MarcEdwin/Design2/README.md

# Design2
This repo hosts work by Smart Vibes for the Design 2 course at Florida Poly.

Feather tutorial: https://learn.adafruit.com/adafruit-feather-m0-wifi-atwinc1500/
