MarcEdwin/Design2/reports/02/02.tex

\documentclass[12pt]{article}

\usepackage{rotating}		% Use sidewaystable command
\usepackage{pdflscape}		% Produce landscape pages in a (mainly) portrait document
\usepackage{float}			% Added this package to place things right where I want them!
\usepackage{mathtools}		% Added this package in order to use shortintertext command
\usepackage{amsmath}
\usepackage{amssymb}
\usepackage{geometry}
\usepackage{graphicx}
\usepackage{tikz}
\usepackage{epstopdf}
\usepackage{caption}
\usepackage{subcaption}
\usepackage{hyperref}

\geometry{letterpaper,tmargin=1in,bmargin=1in,lmargin=1in,rmargin=1in}
\hypersetup{
colorlinks,linkcolor=black,citecolor=violet,urlcolor=blue
}

\allowdisplaybreaks			% Allows equations to be split across multiple pages

\begin{document}

\title{Design 2 Bi-Weekly Report 2}
\author{Smart Vibes}
%\date{January 23, 2017}
\maketitle

\newpage
\tableofcontents

\newpage
\section{These Past Two Weeks}
During the last two weeks, we finalized our bill of materials by updating the price of certain parts and adding in a few more parts necessary for our sensor. Some of these parts include an antenna to extend the range of wireless communication and a capacitor to help the lithium-ion battery charge off the solar panel. In addition, we also revised the functional diagram and started programming the Adafruit Feather microcontroller.

\begin{figure}[H]
    \centering
    
    \caption{Functional diagram for the vibration sensor designed by Smart Vibes. This latest revision highlights the main subsystems of the sensor and depicts the connection between all the components.}
    \label{fig:gantt_chart}
\end{figure}

\begin{table}[H]
	\centering
	\resizebox{\columnwidth}{!}{%
	\begin{tabular}{l|l|c|l|l|r|c|c}
    	Vendor ID & Part Number & Quantity & Price/Unit & Part Description & Cost & Vendor & Datasheet\\ \hline
    	1120 & LSM303 & 2 & \$14.95 & Accelerometer & \$29.90 & \href{https://www.adafruit.com/products/1120}{Adafruit} & \href{https://cdn-shop.adafruit.com/datasheets/LSM303DLHC.PDF}{PDF} \\
    	2693 & N.A. & 2 & \$19.95 & 16GB MicroSD Card & \$39.90 & \href{https://www.adafruit.com/products/2693}{Adafruit} & \href{https://www.adafruit.com/products/2693}{Website} \\
    	2922 & N.A. & 2 & \$8.95 & SD Card Breakout & \$17.90 & \href{https://www.adafruit.com/products/2922}{Adafruit} & \href{http://www.nxp.com/documents/data_sheet/PCF8523.pdf}{PDF} \\
    	& & & & with Coin Cell Battery & & & \\
    	%380 & CR1220 & 2 & \$0.95 & Coin Cell Battery & \$1.90 & \href{https://www.adafruit.com/products/380}{Adafruit} & \href{https://www.adafruit.com/products/380}{Website} \\
    	3061 & N.A. & 1 & \$34.95 & Adafruit Feather & \$34.95 & \href{https://www.adafruit.com/products/3061}{Adafruit} & \href{https://learn.adafruit.com/system/assets/assets/000/030/130/original/atmel-42181-sam-d21_datasheet.pdf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}{PDF} \\
    	353 & N.A. & 2 & \$29.50 & 6600 mAh 3.7V Lithium- & \$59.00 & \href{https://www.adafruit.com/product/353}{Adafruit} & \href{https://cdn-shop.adafruit.com/product-files/353/C450_-_ICR18650_6600mAh_3.7V_20140729.pdf}{PDF} \\
    	& & & & Ion Battery & & \\
    	2747 & N.A. & 1 & \$88.95 & Solar Panel & \$88.95 & \href{https://www.adafruit.com/products/2747}{Adafruit} & \href{https://www.voltaicsystems.com/9-watt-panel}{Website} \\
    	579-MCP73871-2CCI/ML & MCP73871-2CCI/ML & 1 & \$1.94 & Battery Charger & \$1.94 & \href{http://www.mouser.com/ProductDetail/Microchip-Technology/MCP73871-2CCI-ML/?qs=qXsUupcbpXyQfJ2clznZxw\%3D\%3D}{Mouser} & \href{http://www.mouser.com/ds/2/268/22090a-52174.pdf}{PDF} \\
		N.A. & 474-SEN-11744 & 1 & \$61.25 & Geophone & \$61.25 & \href{http://www.mouser.com/ProductDetail/SparkFun-Electronics/SEN-11744/?qs=\%2fha2pyFaduhLW6YoPw5UUIdTRP1X\%252btPruyfOHvl8\%2fY0\%3d}{Mouser} & \href{http://cdn.sparkfun.com/datasheets/Sensors/Accelerometers/SM-24\%20Brochure.pdf}{PDF} \\
    	 39RL33 & N.A. & 1 & \$34.75 & White Nylon Filament & \$34.75 & \href{https://www.grainger.com/product/FILABOT-White-Filament-39RL33}{Grainger} & \href{https://www.grainger.com/product/FILABOT-White-Filament-39RL33}{Website} \\
    	 & & & & for 3-D Printer & & \\
    	 2788 & N.A. & 1 & \$0.95 & DC Jack Adapter Cable & \$0.95 & \href{https://www.adafruit.com/products/2788}{Adafruit} & \href{https://www.adafruit.com/products/2788}{Website} \\
    	 & & & & for Battery Charger & & & \\
    	 581-TAP475K016SCS & TAP475K016SCS & 1 & \$0.67 & Tantalum Capacitor & \$0.67 & \href{http://www.mouser.com/ProductDetail/AVX/TAP475K016SCS/?qs=sGAEpiMZZMtZ1n0r9vR22d\%252b8XmbM9QM8L4TTXY3LGQ8\%3d}{Mouser} & \href{http://www.mouser.com/ds/2/40/tap-776819.pdf}{PDF} \\
    	 & & & & for Battery Charger & & & \\
    	 261 & N.A. & 1 & \$0.75 & JST 2-pin Cable & \$0.75 & \href{https://www.adafruit.com/product/261}{Adafruit} & \href{https://www.adafruit.com/product/261}{Website} \\
    	 & & & & for Battery Charger & & & \\
    	 	PMT-37N28AL01-04-ND & PMT-37N28AL01-04 & 1 & \$8.57 & Speaker & \$8.57 & \href{http://www.digikey.com/product-detail/en/peerless-by-tymphany/PMT-37N28AL01-04/PMT-37N28AL01-04-ND/6211115}{Digi-Key} & \href{http://www.tymphany.com/wp-content/themes/pathfinders/cache/pdfs/PMT-37N28AL01-04.pdf}{PDF} \\
        2308 & N.A. & 1 & \$2.50 & Antenna with uFL & \$2.50 & \href{https://www.adafruit.com/products/2308}{Adafruit} & \href{https://www.adafruit.com/products/2308}{Website} \\
    	 & & & & Connector & & & \\ \hline
    	Total Cost & & & & & \$381.98 &
	\end{tabular}%
	}
    \caption{Bill of materials for the vibration sensor designed by Smart Vibes. This latest revision ensures compatibility between all the components.}
    \label{tab:bom}
\end{table}

\section{What's Next?}
\begin{itemize}
\item Keep programming and familiarizing ourselves with the microcontroller.
\item Order the parts in our BOM.
\item Work on the design of our housing using prototyping foam.
\end{itemize}

\section{Responsibilities}
The responsibilities of each group member has not changed since the last report. The distribution of work in Smart Vibes is as follows:\\

\noindent \textbf{Joshua Watkins} - \textit{Mechanical/Design} - Responsibilities include designing an enclosure for the sensors that will maximize the sensor's capabilities while minimizing cost.\\

\noindent \textbf{Marc-Edwin Rigaud} - \textit{Programming} - Responsibility is to program the microcontroller, and arrange website and cloud-based services.\\

\noindent \textbf{Jordan Faison} - \textit{Electrical/Design/Programming} - Responsibilities will be assisting in design from an electrical aspect, as well as software development.\\

\noindent \textbf{Ezequiel Juarez G.} - \textit{Electrical/Programming} - Responsibilities include assembling the vibration sensor system using all of the electronics at our disposal and aiding with the programming/debugging of software.

\end{document}
