MarcEdwin/Design2/docs/sensor_improvements.md

## Battery improvements

- temperature sensor across THERM
- 1kohm resistor across PROG
- run mini-usb port to the outside for charging
