MarcEdwin/Design2/presentations/04_Design_2_Progress_Presentation_2.pdf

# SmartVibes

# Progress Report Deux

What we set out to create...

Smart Structures asked us to design a robust and portable vibration monitoring solution.

The solution would be used to monitor ground vibrations at a construction site.

We decided it needed to meet the following requirements:

- Use an accelerometer and geophone
- Monitor minimum frequency of 8hz
- Store data locally
- Provide immediate emergency triggers
- Provide real time monitoring
- Have WiFi connectivity
- Cloud database, remote access
- Four-week power time
- Weather resistant

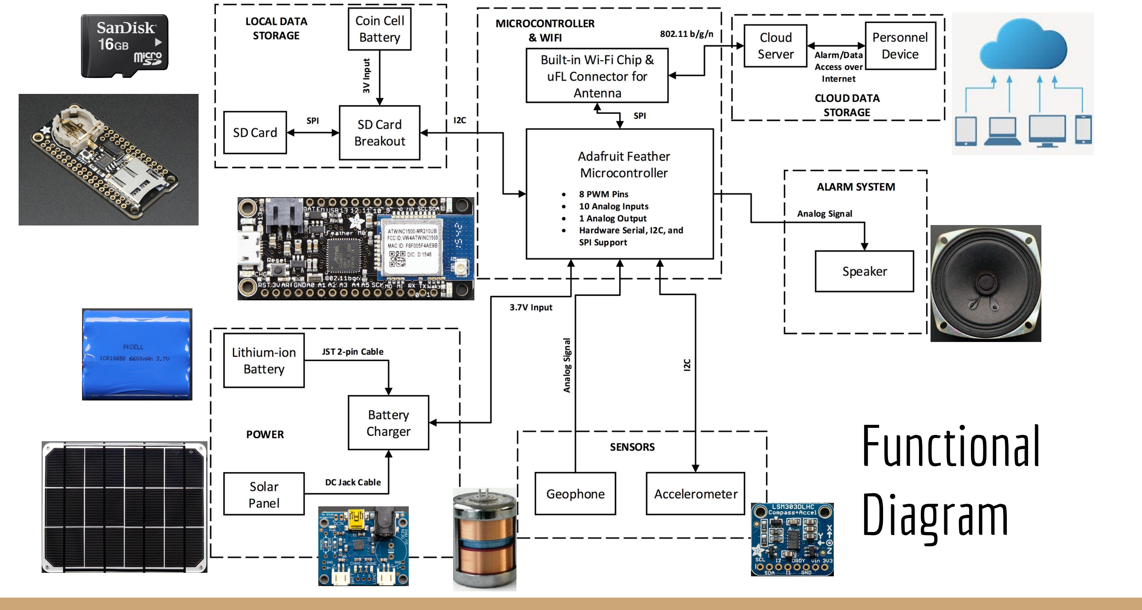
[picture p14: page 3]

# Functional Diagram

# State of Enclosure

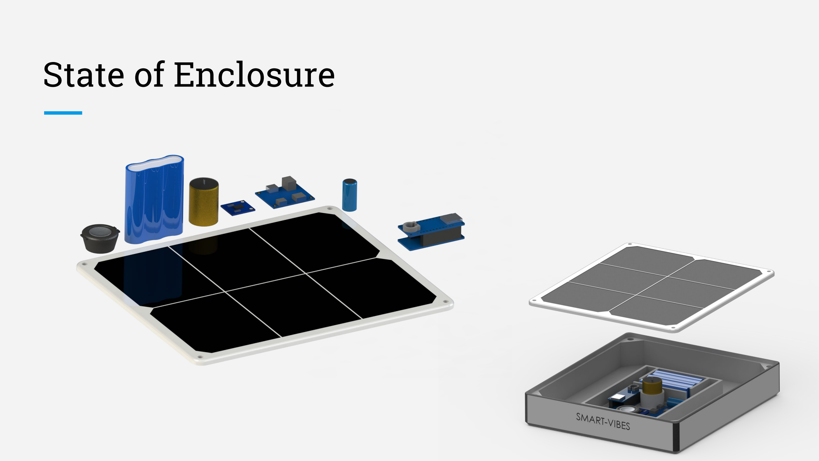
[picture p15: page 4]

# State of Enclosure

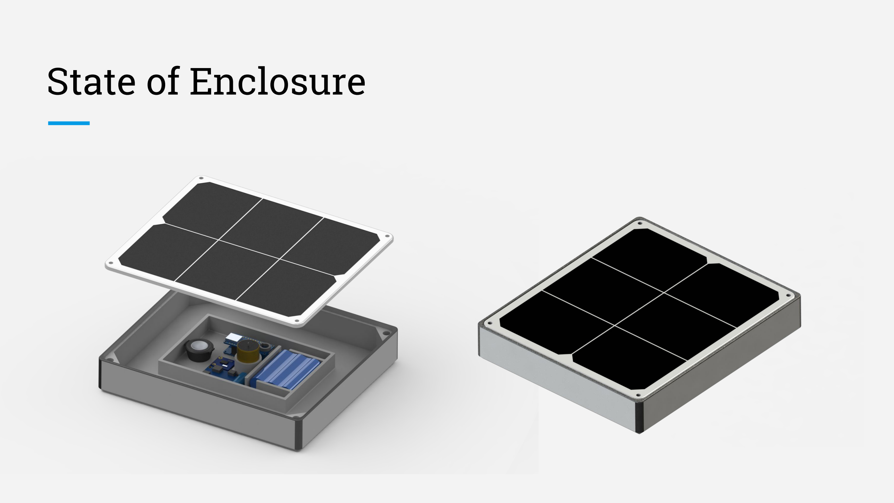
[picture p16: page 5]

# State of Sensors

Progress

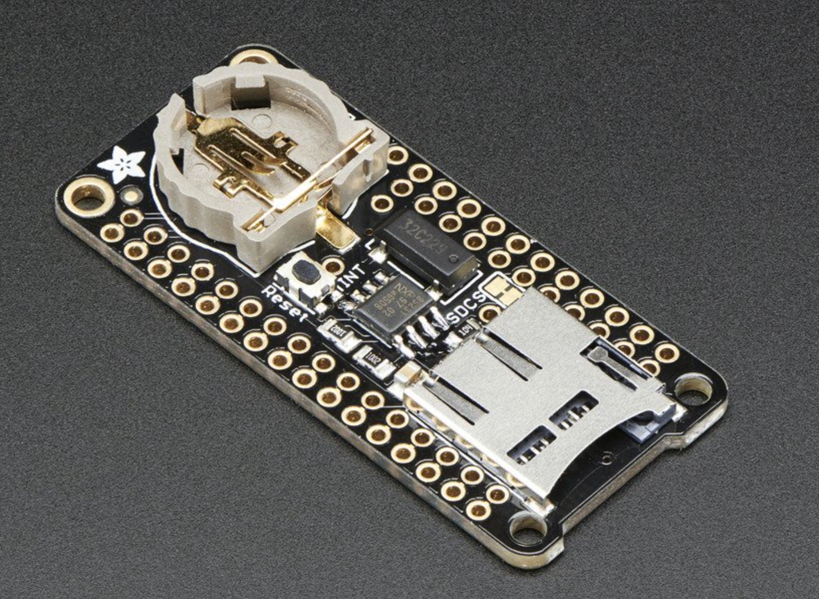
[picture p17: figure]

- Accelerometer data is being gathered over I2C.
- RTC clock has been set. Data can now be timestamped correctly.
- Analog data from geophone is being collected.

Problems

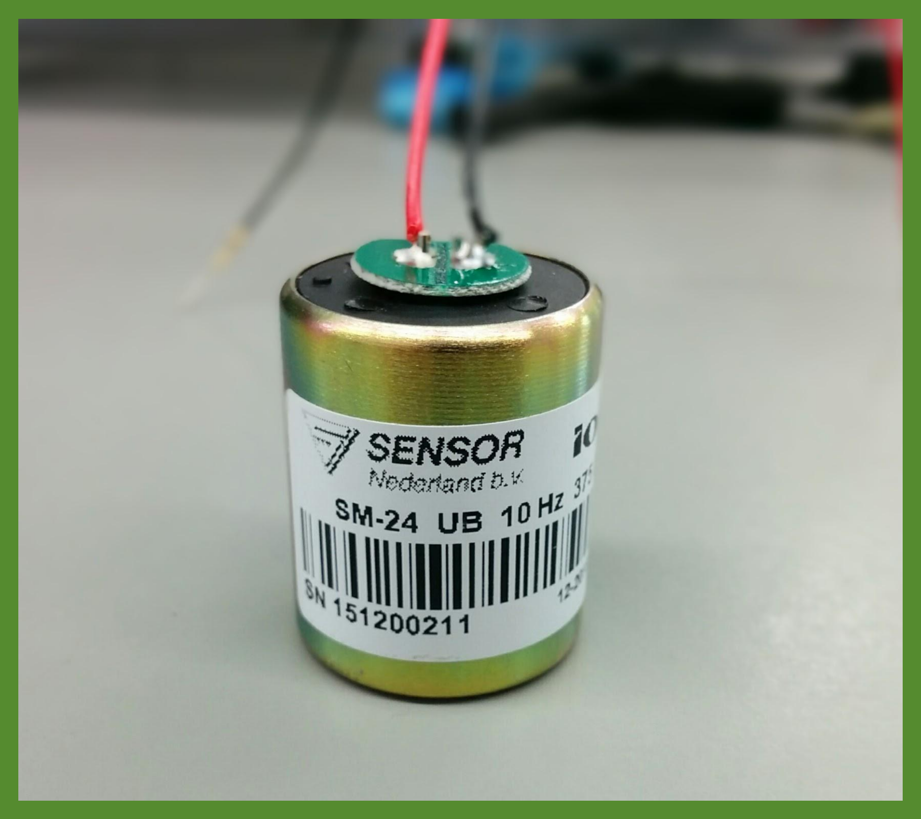
[picture p18: figure]

- Interrupts are have been difficult to set up.
- Lack of accessible FFT library for the Feather makes it difficult to calculate the frequency of vibrations.

# State of Sensors

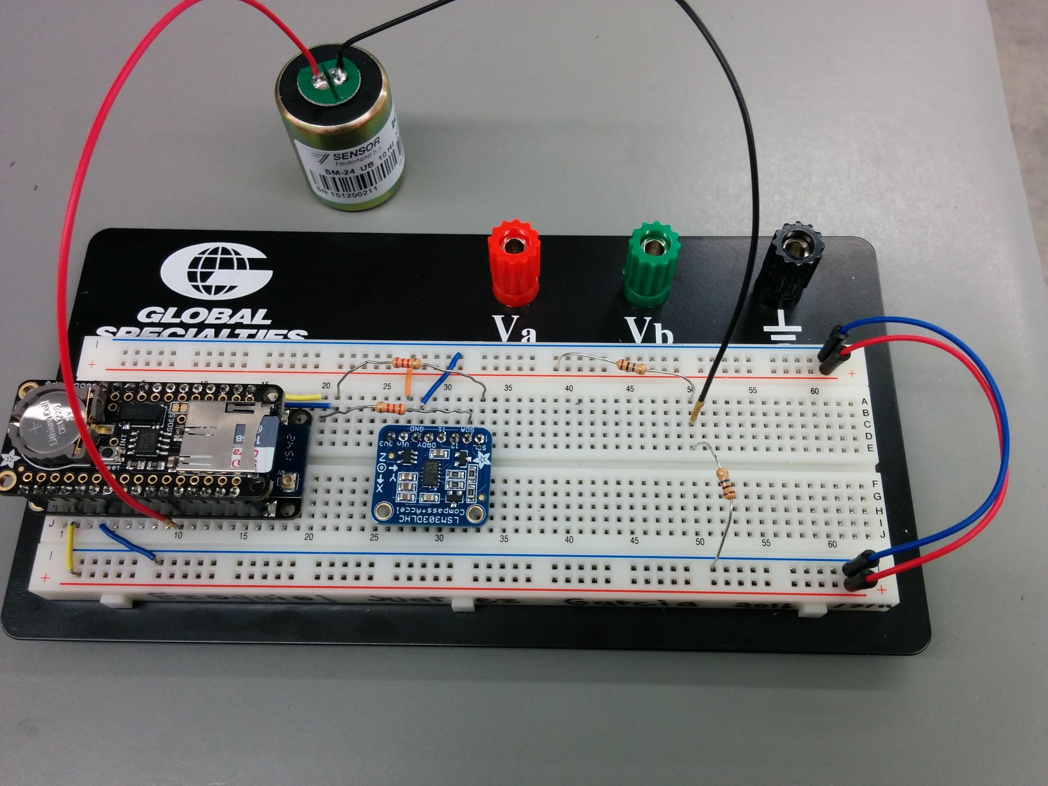
[picture p19: figure]

# State of Data-linking

- Now using Microsoft Azure IoT Hub platform
- This allows us to send messages to and from the Feather via wireless module
- It uses gulp.js, a toolkit that allows us to automate tasks
- Create Functions that make these messages meaningful
- Data Storage/ Management
- Data interrupts and signal issues
- Alarm system

# Next Steps

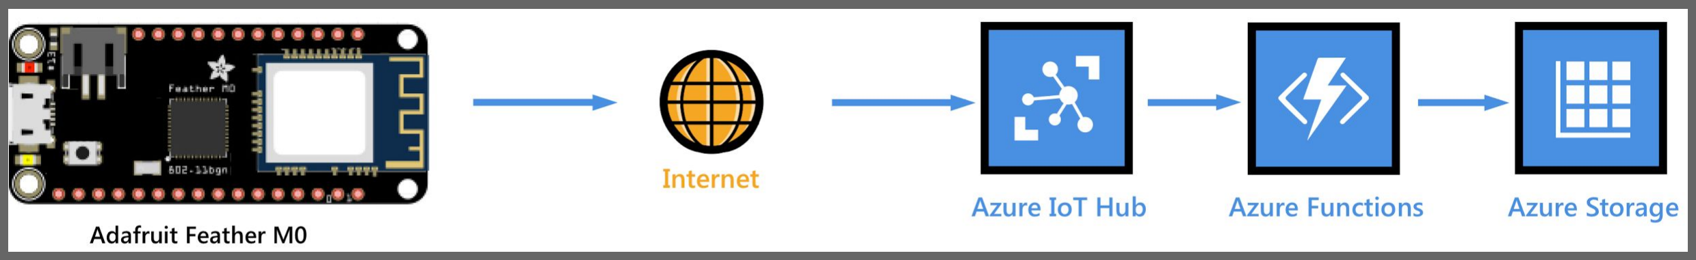
[picture p20: figure]

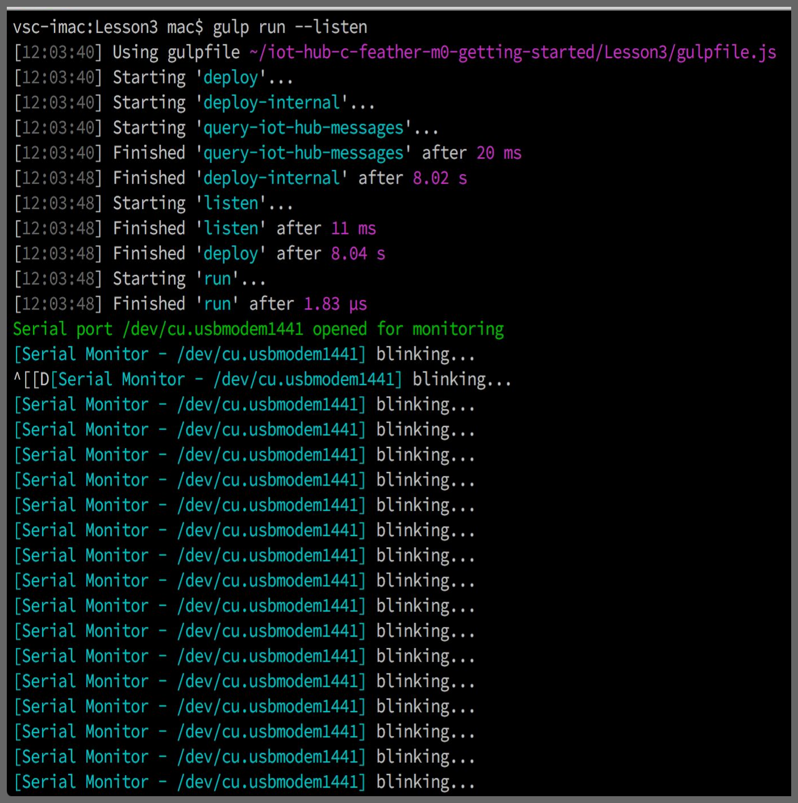
[picture p21: figure]

# State of Data-linking

Using gulp file to send messages

reporting to the serial monitor and

sending them to the database

# State of Database

- We will be using Microsoft Azure IoT’s built in storage known as Microsoft

Azure Storage.

- The specific database we will use is Table Storage.
- Table storage is a NoSQL key-attribute data store, which allows for rapid

development and fast access to large quantities of data.

# State of Database cont'd

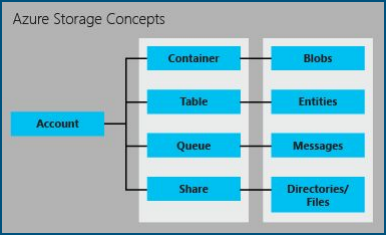
[picture p22: figure]

# What's Next?

- Collect both geophone and accelerometer data and store on SD card.
- Program alarm.
- Look into the FFT problem.
- Collectively look into the battery and solar power aspect.
- 3-D print the housing.

# Division of Work

Josh - Enclosure

Zeq- Sensor array

Jordan- Data linking

Marc- Database
