MarcEdwin/Design2/presentations/02_Design_2_Bi-Weekly_Presentation_Never_Presented.pdf

# Design 2 Bi-Weekly Presentation 2

## Smart Vibes January 23, 2016

These Past Two Weeks….

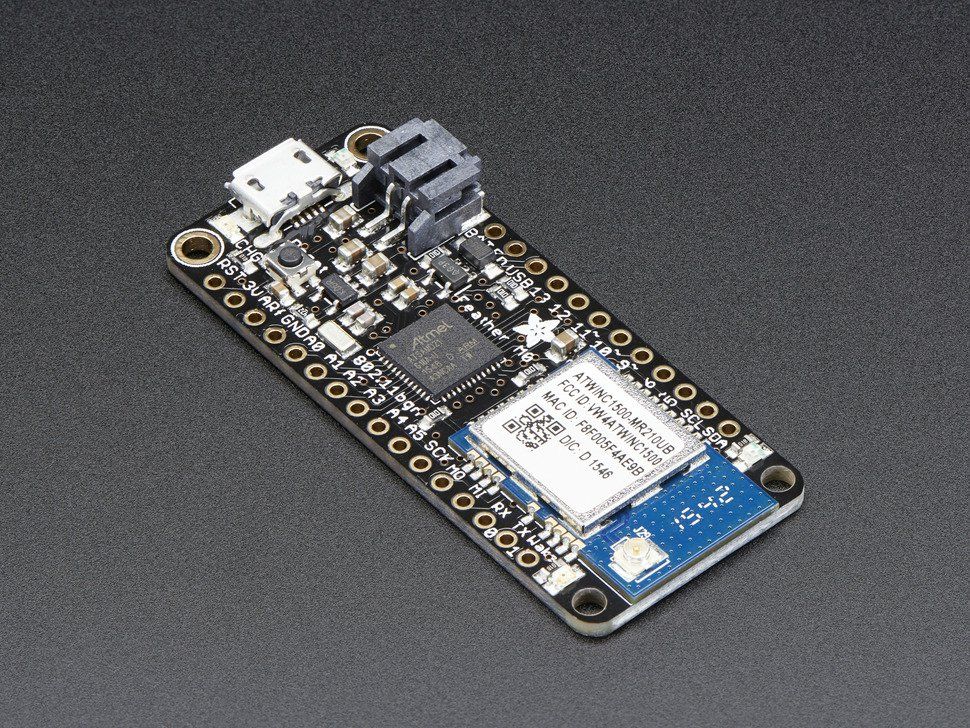
[picture p23: figure]

We started programming

the Adafruit Feather

microcontroller.

# Modified the BOM

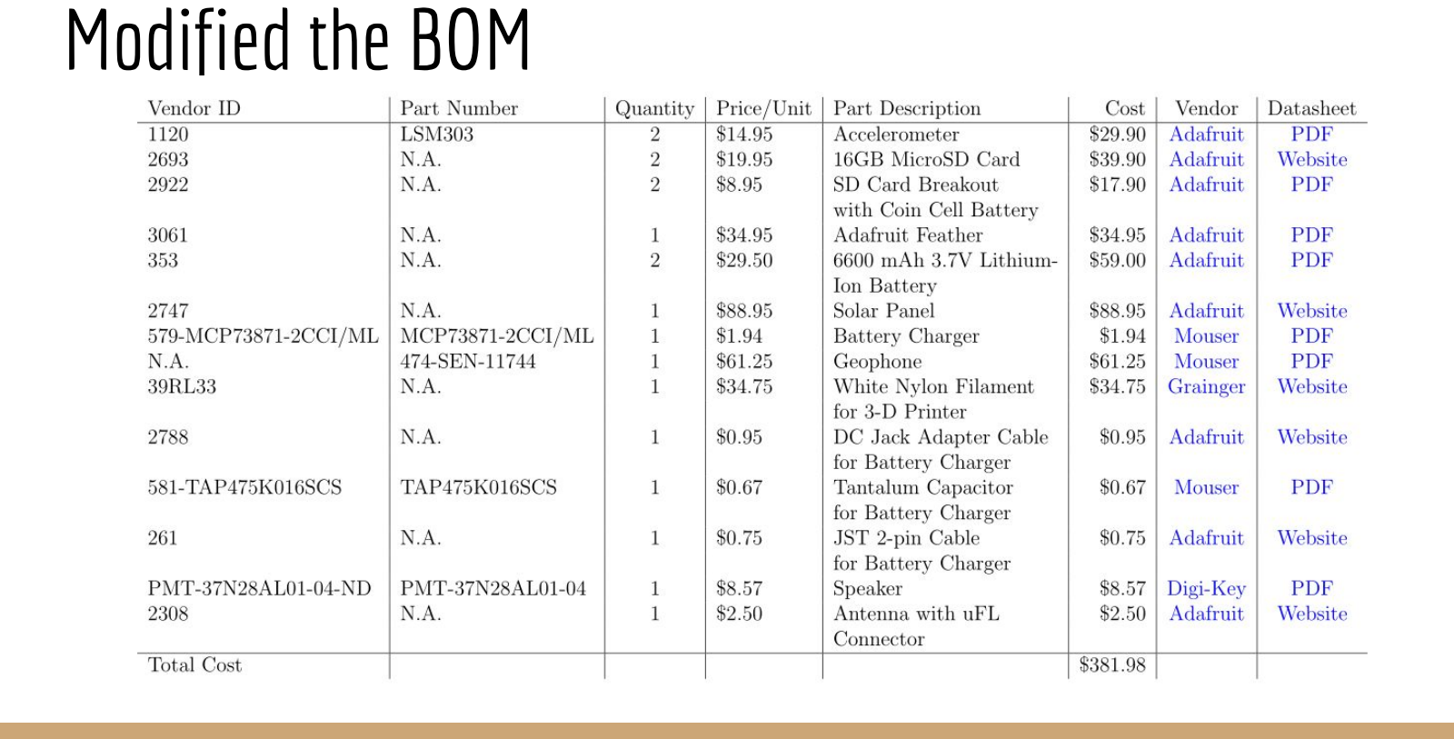
[picture p24: page 3]

# Modified the Functional Diagram

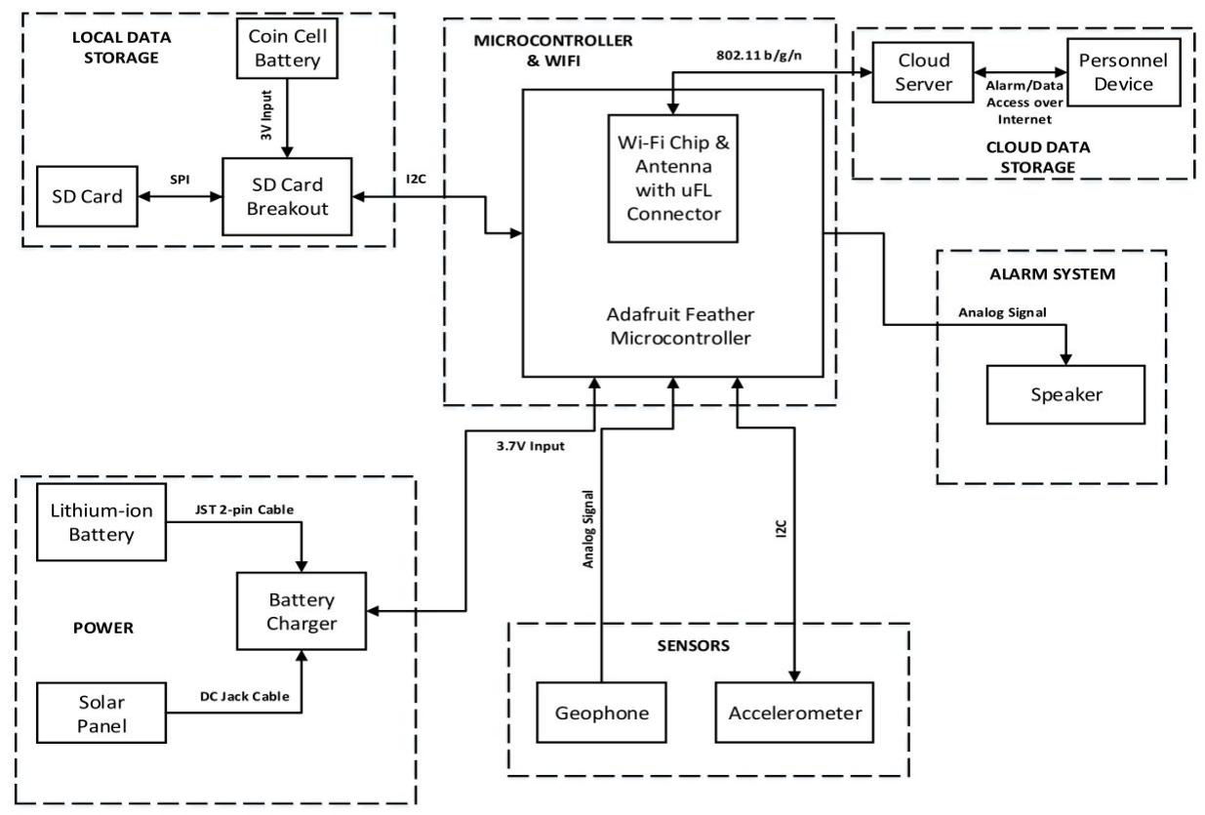
[picture p25: figure]

# What’s Next

- Keep programming and familiarizing ourselves with the microcontroller.
- Order the parts in our BOM.
- Work on the design of our housing using prototyping foam.

# Work Distribution

Joshua Watkins - Mechanical/Design

Marc-Edwin Rigaud - Programming

Jordan Faison - Electrical/Design/Programming

Ezequiel Juarez - Electrical/Programming

# Questions? Comments? Compliments?
