MarcEdwin/Design2/reports/02/02.pdf

# Design 2 Bi-Weekly Report 2

### Smart Vibes

### February 6, 2017

## Contents

1 These Past Two Weeks | 3
2 What’s Next? | 4
3 Responsibilities | 4

## 1 These Past Two Weeks

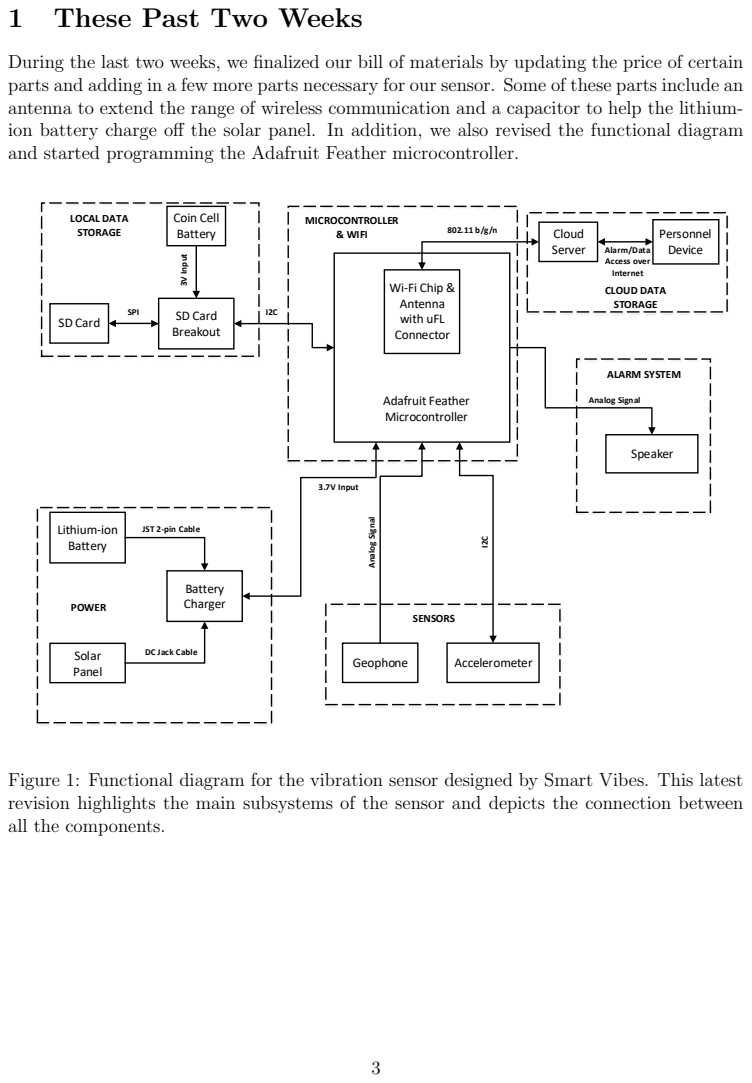
[picture p26: page 3]
Adafruit Feather Microcontroller; SD Card Breakout; Coin Cell Battery; SD Card; Cloud Server; Personnel Device; Geophone; Accelerometer; Lithium-ion Battery; Battery Charger; Solar Panel; Speaker; Analog Signal; Alarm/Data Access over Internet; SPI; 3.7V Input; 3V Input; ALARM SYSTEM; MICROCONTROLLER & WIFI; CLOUD DATA STORAGE; LOCAL DATA STORAGE; SENSORS; POWER

During the last two weeks, we finalized our bill of materials by updating the price of certain
parts and adding in a few more parts necessary for our sensor. Some of these parts include an
antenna to extend the range of wireless communication and a capacitor to help the lithium-
ion battery charge off the solar panel. In addition, we also revised the functional diagram
and started programming the Adafruit Feather microcontroller.

Wi-Fi Chip &
Antenna
with uFL
Connector

JST 2-pin Cable

DC Jack Cable

Figure 1: Functional diagram for the vibration sensor designed by Smart Vibes. This latest
revision highlights the main subsystems of the sensor and depicts the connection between
all the components.

Vendor ID | Part Number | Quantity | Price/Unit | Part Description | Cost | Vendor | Datasheet
1120 | LSM303 | 2 | $14.95 | Accelerometer | $29.90 | Adafruit (https://www.adafruit.com/products/1120) | PDF (https://cdn-shop.adafruit.com/datasheets/LSM303DLHC.PDF)
2693 | N.A. | 2 | $19.95 | 16GB MicroSD Card | $39.90 | Adafruit (https://www.adafruit.com/products/2693) | Website (https://www.adafruit.com/products/2693)
2922 | N.A. | 2 | $8.95 | SD Card Breakout | $17.90 | Adafruit (https://www.adafruit.com/products/2922) | PDF (http://www.nxp.com/documents/data_sheet/PCF8523.pdf)
| | | | with Coin Cell Battery
3061 | N.A. | 1 | $34.95 | Adafruit Feather | $34.95 | Adafruit (https://www.adafruit.com/products/3061) | PDF (https://learn.adafruit.com/system/assets/assets/000/030/130/original/atmel-42181-sam-d21_datasheet.pdf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)
353 | N.A. | 2 | $29.50 | 6600 mAh 3.7V Lithium- | $59.00 | Adafruit (https://www.adafruit.com/product/353) | PDF (https://cdn-shop.adafruit.com/product-files/353/C450_-_ICR18650_6600mAh_3.7V_20140729.pdf)
| | | | Ion Battery
2747 | N.A. | 1 | $88.95 | Solar Panel | $88.95 | Adafruit (https://www.adafruit.com/products/2747) | Website (https://www.voltaicsystems.com/9-watt-panel)
579-MCP73871-2CCI/ML | MCP73871-2CCI/ML | 1 | $1.94 | Battery Charger | $1.94 | Mouser (http://www.mouser.com/ProductDetail/Microchip-Technology/MCP73871-2CCI-ML/?qs=qXsUupcbpXyQfJ2clznZxw%3D%3D) | PDF (http://www.mouser.com/ds/2/268/22090a-52174.pdf)
N.A. | 474-SEN-11744 | 1 | $61.25 | Geophone | $61.25 | Mouser (http://www.mouser.com/ProductDetail/SparkFun-Electronics/SEN-11744/) | PDF (http://cdn.sparkfun.com/datasheets/Sensors/Accelerometers/SM-24%20Brochure.pdf)
39RL33 | N.A. | 1 | $34.75 | White Nylon Filament | $34.75 | Grainger (https://www.grainger.com/product/FILABOT-White-Filament-39RL33) | Website (https://www.grainger.com/product/FILABOT-White-Filament-39RL33)
| | | | for 3-D Printer
2788 | N.A. | 1 | $0.95 | DC Jack Adapter Cable | $0.95 | Adafruit (https://www.adafruit.com/products/2788) | Website (https://www.adafruit.com/products/2788)
| | | | for Battery Charger
581-TAP475K016SCS | TAP475K016SCS | 1 | $0.67 | Tantalum Capacitor | $0.67 | Mouser (http://www.mouser.com/ProductDetail/AVX/TAP475K016SCS/) | PDF (http://www.mouser.com/ds/2/40/tap-776819.pdf)
| | | | for Battery Charger
261 | N.A. | 1 | $0.75 | JST 2-pin Cable | $0.75 | Adafruit (https://www.adafruit.com/product/261) | Website (https://www.adafruit.com/product/261)
| | | | for Battery Charger
PMT-37N28AL01-04-ND | PMT-37N28AL01-04 | 1 | $8.57 | Speaker | $8.57 | Digi-Key (http://www.digikey.com/product-detail/en/peerless-by-tymphany/PMT-37N28AL01-04/PMT-37N28AL01-04-ND/6211115) | PDF (http://www.tymphany.com/wp-content/themes/pathfinders/cache/pdfs/PMT-37N28AL01-04.pdf)
2308 | N.A. | 1 | $2.50 | Antenna with uFL | $2.50 | Adafruit (https://www.adafruit.com/products/2308) | Website (https://www.adafruit.com/products/2308)
| | | | Connector
Total Cost | | | | | $381.98

Table 1: Bill of materials for the vibration sensor designed by Smart Vibes. This latest revision ensures compatibility between all the components.

## 2 What’s Next?

- Keep programming and familiarizing ourselves with the microcontroller.
- Order the parts in our BOM.
- Work on the design of our housing using prototyping foam.

## 3 Responsibilities

The responsibilities of each group member has not changed since the last report. The distribution of work in Smart Vibes is as follows:

Joshua Watkins - Mechanical/Design - Responsibilities include designing an enclosure for the sensors that will maximize the sensor’s capabilities while minimizing cost.

Marc-Edwin Rigaud - Programming - Responsibility is to program the microcontroller, and arrange website and cloud-based services.

Jordan Faison - Electrical/Design/Programming - Responsibilities will be assisting in design from an electrical aspect, as well as software development.

Ezequiel Juarez G. - Electrical/Programming - Responsibilities include assembling the vibration sensor system using all of the electronics at our disposal and aiding with the programming/debugging of software.
