MarcEdwin/Design2/reports/02/src/functional_diagram.pdf

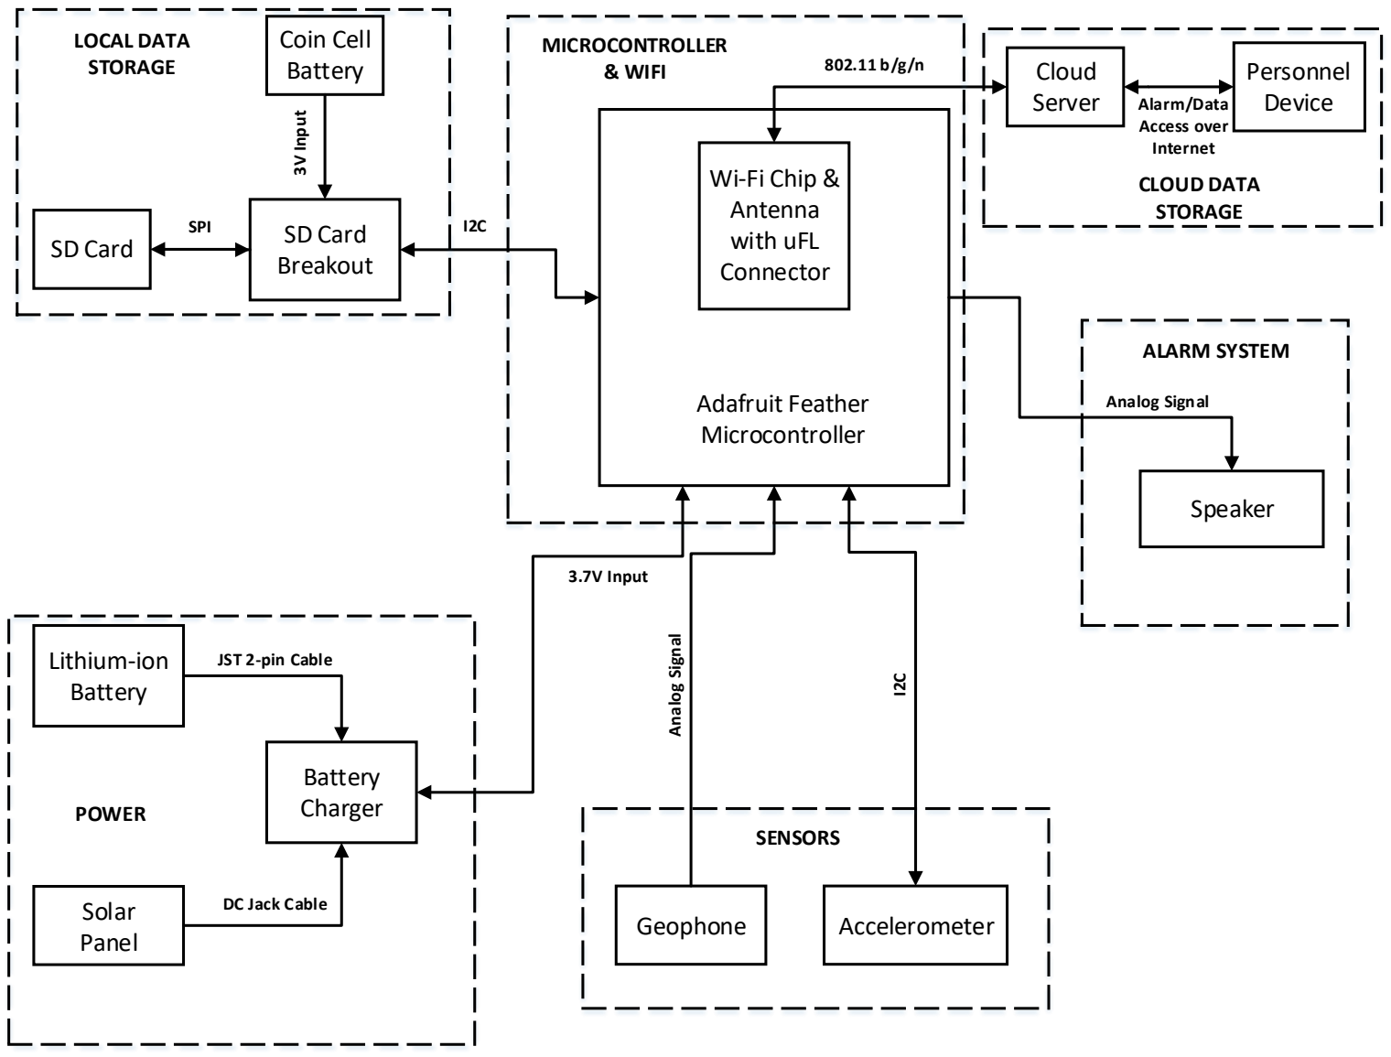
[picture p27: page 1]

Adafruit Feather
Microcontroller

SD Card
Breakout

Coin Cell
Battery

SD Card

Cloud
Server

Personnel
Device
Geophone | Accelerometer

Lithium-ion
Battery

Battery
Charger

Solar
Panel

Speaker

Wi-Fi Chip &
Antenna
with uFL
Connector

JST 2-pin Cable

DC Jack Cable

Analog Signal

I2C

Analog Signal

802.11 b/g/n

Alarm/Data
Access over
Internet
SPI | I2C

3.7V Input

3V Input

ALARM SYSTEM

MICROCONTROLLER
& WIFI

CLOUD DATA
STORAGE

LOCAL DATA
STORAGE

SENSORS

POWER
