MarcEdwin/Design2/functional_diagram/functional_diagram.pdf

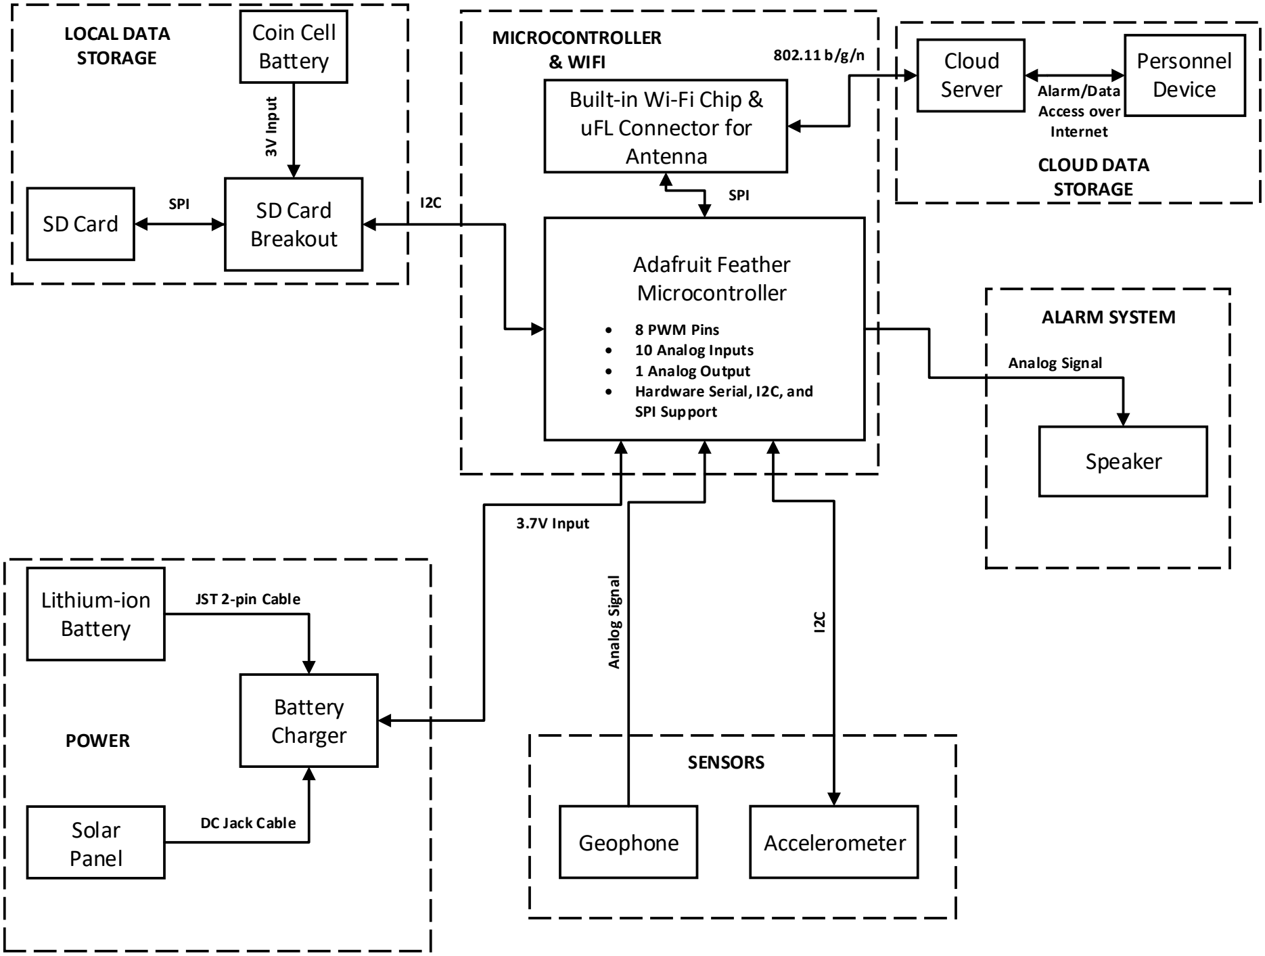
[picture p28: figure]
Adafruit Feather Microcontroller; SD Card Breakout; Coin Cell Battery; SD Card; Cloud Server; Personnel Device; Geophone; Accelerometer; Lithium-ion Battery; Battery Charger; Solar Panel; Speaker; Built-in Wi-Fi Chip & uFL Connector for Antenna; JST 2-pin Cable; DC Jack Cable; Analog Signal; Alarm/Data Access over Internet; SPI; 3.7V Input; 3V Input; ALARM SYSTEM; MICROCONTROLLER & WIFI; CLOUD DATA STORAGE; LOCAL DATA STORAGE; SENSORS; POWER; • 8 PWM Pins • 10 Analog Inputs • 1 Analog Output • Hardware Serial, I2C, and SPI Support
