MarcEdwin/Design2/sldr/sldr.pdf

# System Level Design Report

### Smart Vibes

### December 16, 2016

## Contents

1 Introduction | 3
2 System Overview | 4
3 System Architecture | 5
4 Bill of Materials | 8
5 Risks | 8
6 Technology Readiness Level | 11
7 Gantt Chart | 13

## 1 Introduction

### 1.1 Product Opportunity

Construction companies use vibrations sensors at or near construction sites of projects; they do this in order to be aware of the ground vibrations they are introducing into the surrounding area. Depending on the material composition of the buildings in the vicinity, the construction company will have a threshold value for vibration magnitudes that they will need to stay under. Without any monitoring system, workers operating heavy machinery can cause damage to the structural integrity of the surrounding buildings. Therefore, companies like Smart Structures are in need of a system that alerts them if a construction activity or natural phenomenon has compromised the integrity of an ongoing or finished project.

### 1.2 Customer Needs

The final product will adhere to the specifications provided by Smart Structures, both in design and engineering. The new sensor will need to be portable and easy to transport, in contrast to the current ones, which are embedded into the ground. Because of this, the old sensors require any data to be recorded on site, which is costly and time consuming. Changes will not only make the new sensor solution mobile, but will also provide daily transmissions to the cloud and real time alerts. The battery included within the sensor will last up to four weeks, additionally cutting down on human interference. Also, considering the sensor will be exposed out in the construction site, it will also need to meet certain conditions such as; high and low temperature tolerance, waterproofing, and shock/impact resistance.

### 1.3 Technical Specifications

- Accelerometer and geophone
- Monitor minimum frequency of 8Hz
- Local data storage
- Immediate emergency triggers
- Remote access
- Four week power time
- Cloud database
- Weather resistant
- Wifi connectivity
- Real-time monitoring
- Server access

### 1.4 Constraints

The overall restrictions in the desired product ultimately affected its design process and implementation. While any conventional plastic case could have satisfied the housing aspect of our design, Smart Structures preferred a weatherproof enclosure. This enclosure needed to be capable of withstanding impacts and collision of high magnitudes, sub-zero temperatures, extreme heat, and moisture/precipitation. Portability was also an important factor and constraint for the case, which culminated in the current design. For prototyping; a 3-D model will be constructed in order to further assess if any changes need to be made to the composition. The finished product will ultimately be durable, yet small enough to be able to be moved to different areas, as deemed necessary.
The next design constraint that we faced was meeting the desired battery life of one month. This design required a search for low-power electronics that would keep the power usage down, but would still deliver the same performance as other power-hungry devices. For the microcontroller in the prototype, we opted to use a wifi-capable microcontroller from Adafruit. It draws very little current and can parse the data of the accelerometer and geophone sensors without a problem.

## 2 System Overview

Smart-Structures is looking for an accurate and reliable way to collect real-time ground vibrations at or around active construction sites. Construction projects are restricted in what’s considered an acceptable vibration range based on the location of the project. Generally, in urban areas and near protected public places such as schools and hospitals have much lower tolerances for vibration noise.
Swiss standards SN 640 312a [1] for building damages are typically used when monitoring construction vibrations to be assured that both cosmetic and structural damage is eliminated while complaints are minimized. There are two types of fundamental mechanisms for vibration damage. The first type is distortion from inertial loads and the second is the settlement of the soils supporting the foundation. Although serious structural damage is possible, the materials that begin to crack under stress are often brittle such as drywall or plaster.
A combination of old and new techniques are used to minimize power consumption and maximize reliability. Using a strong weather-proof case, lithium polymer ion battery, geophone, accelerometer, and a microcontroller, we can accurately observe, record, and transmit valuable data. This report highlights the key features and analyzes the design, materials, electronics, potential risks, mitigation plans, and the project timeline.

## 3 System Architecture

### 3.1 High Level View


Figure 1: Prototype design for the vibration monitoring systems. The design highlights the subsystems of the sensor. The top picture is the top view of the system. The bottom picture shows what’s underneath the solar panel inside the system.

Figure 1 shows the prototype system designed by Smart Vibes. Data is collected from the geophone and accelerometer sensors. This data is processed by the microcontroller, for our application we are using an Adafruit Feather; a low cost, open source module that has an integrated wifi module. The chip has enough processing power to take information from the geophone and convert it to data that can be used to determine critical level vibrations. When not on alert or transmission mode, the data is stored on the SD card. The Feather has two modes, an active and a low power consumption mode, which allows for smart power usage when signals are below a threshold. At the end of day, the wifi module on the system pushes the data to the cloud where it can be viewed any time by authorized personnel at Smart Structures. The system will include an antenna, that will protrude from the case to extend the range of transmission.

### 3.2 Design Rationale

The choice for system architecture was due to three main reasons; first, the system needed to eliminate the human interaction with the collection of vibration data. Second, the system needed to be portable and withstand certain atmospheric conditions. Finally, the system had to run for at least a month before recharging.
The first issue encountered was selecting the right microcontroller. For the initial concept design a Raspberry Pi was chosen, but seeing that it would draw too much current and drain the battery quickly, it was replace with an Arduino Pro Mini microcontroller based on the Atmega processing chip. However, this would have required an extra wifi breakout board and a separate antenna board to extend the transmission range. Therefore, the final design uses an integrated microcontroller board from Adafruit that comes with a wifi module and a connection for an antenna.
The second issue with the design was finding the right battery to power the system. It was unknown what kind of battery was suitable to power all the different electronics for a full month. After, switching over from the Arduino Pro Mini to the Adafruit Feather as the microcontroller, the voltage necessary to power the entire system by analyzing the voltage requirements of all the components was finalized. All of the components in the system will run of a 3.7V battery.
Finally, the sensor housing case which had originally been designed as a flat box, was redesigned to into a dome. The dome will redistribute the force towards the edges, whereas a flat box would absorb the shock, possibly damaging the center. As far as materials go, the current preferred material is acrylonitrile butadiene styrene; also known as ABS. ABS is a common type of thermoplastic polymer that is impact resistant, durable, and heat resistant. ABS can be further strengthened by molding it at low temperatures, or adding glass fibers. This choice for housing material will ensure that the main components are safe from the elements.

### 3.3 Subsystems

Figure 1 shows the main subsystems of the solution. The seven main subsystems in our design are the following:

- Microcontroller
- Storage
- Wifi
- Accelerometer
- Geophone
- Battery
- Solar panel

### 3.4 Interfaces

For the microcontroller an Adafruit Feather was selected, which is a low-power consumption, open-source microcontroller that has an integrated wifi module. For storage requirements, an SD card attached to the Feather provides sufficient means to store data before it is pushed to the cloud database. The Feather’s integrated wifi module operates in low-power mode when it is not transmitting data.
The accelerometer senses changes in position and correlates them to ground vibrations. The geophone is composed of a spring that generates a voltage which is translated to a seismic readings. The two systems provide redundancy against erroneous readings from one sensor.
To extend the battery life of the device as much as possible, there was a need for the system to recharge the battery. Therefore, it was decided to implement and attach a solar panel to the device so that the battery can be recharged when the system is running during the day.

### 3.5 Concept of Operations

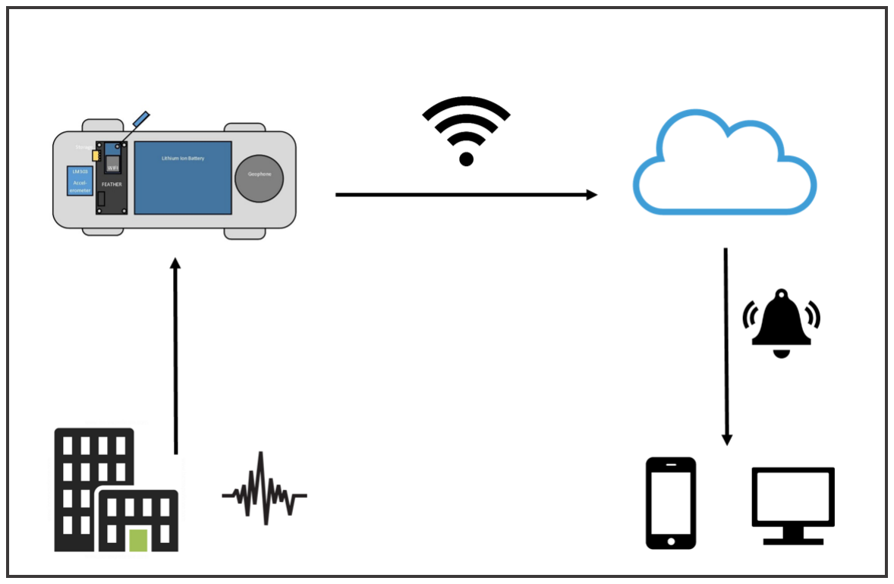
[picture p29: figure]

Figure 2: Diagram depicting the concept of operations of the vibration monitoring system.

The sensor will detect vibrations in a surrounding zone, such as construction site. It will determine one of two things; whether the vibrations are with a certain threshold or not. If not then it will send an alert via the web to someone who can respond to it. Meanwhile, it is also constantly sampling and storing data. Once a day this data gets sent to a cloud database for analysis. Figure 2 illustrates the concept of operations with a visual.

## 4 Bill of Materials

The bill of materials in Table 1 contains tentative “off-the-shelf” parts that will need to be purchased in order to construct a functional prototype. The materials listed below have been selected after hours of research and fit the criteria needed to construct a weatherproofed, reliable system.

Vendor ID | Part Number | Quantity | Price/Unit | Part Description | Related Customer Need | Total Cost | Vendor
1120 | LSM303 | 2 | $14.95 | Accelerometer | Measuring vibrations generated | $29.90 | Adafruit (https://www.adafruit.com/products/1120)
| | | | | near a construction site.
2693 | N.A. | 2 | $19.95 | 16GB MicroSD Card | Storing entire day’s worth of data | $39.90 | Adafruit (https://www.adafruit.com/products/2693)
| | | | | before it is sent to the cloud.
2922 | N.A. | 2 | $8.95 | SD Card Add-On | Used to assist on-board storage | $17.90 | Adafruit (https://www.adafruit.com/products/2922)
| | | | | of data.
380 | CR1220 | 2 | $0.95 | Coin Cell Battery | Assist in the storage of data. | $1.90 | Adafruit (https://www.adafruit.com/products/380)
3061 | N.A. | 2 | $29.95 | Adafruit Feather | Processing and monitoring the | $69.90 | Adafruit (https://www.adafruit.com/products/3061)
| | | | Microcontroller with Wifi | recorded vibrations.
353 | N.A. | 2 | $29.50 | 6600 mAh 3.7V Lithium- | Power sensor for extended periods | $59.00 | Adafruit (https://www.adafruit.com/product/353)
| | | | Ion Battery | of time, without needing human
| | | | | interaction.
2747 | N.A. | 1 | $88.95 | Solar Panel | Extend the life of the battery. | $88.95 | Adafruit (https://www.adafruit.com/products/2747)
390 | N.A. | 1 | $17.50 | Solar Panel Adapter | Protect the battery and the | $17.50 | Adafruit (https://www.adafruit.com/products/390)
| | | | | microcontroller.
N.A. | 474-SEN-11744 | 1 | $61.25 | Geophone | Measure ground vibrations. | $61.25 | Mouser (http://www.mouser.com/ProductDetail/SparkFun-Electronics/SEN-11744/)
N.A. | N.A. | 2 | $0.00 | Enclosure Material | House the system prototype. | $0.00 | 3D-Printed
Total | | | | | | $386.20

Table 1: Bill of materials.

## 5 Risks

1. Case Breakage

The housing for the sensor must be resistant to weather, shock, dust, and other material foreign to the sensor. In the event that the exterior of the housing was not properly constructed, any impact would damage the inside components. If the housing were to break, it could introduce foreign material into the device, leading to a system failure. Therefore, the components will be covered in a waterproof case which will serve as a safeguard. The design of the case itself will be a shock proof, dome-like design which will provide a larger area for impact absorption.

2. Battery Life

The battery needs to be able to last for the duration of peak construction periods, or up to four weeks. Due to the possibility that the device will be left outdoors for an extended duration of time, the battery needs to be able to withstand temperatures ranging from -20 to 50 degrees Celsius. This temperature range is determined from the operation range data provided in the datasheet of the battery. If this battery cannot withstand the conditions, it could ignite or leak. Another possibility is that the chosen battery will not last the required amount of time. However, the selected battery has specifications that will perform as needed under those conditions.

3. Poor Surface Contact

If the sensor is not placed in direct contact with the surface it is measuring, there is a chance the signal will be dampened or not recorded. Loss of sensory abilities could result in a failure to detect unsafe levels of vibration. Several low and high fidelity tests will be completed to establish the limits of detection under different circumstances. With that information, an appropriate sensor design will be completed, which will have limited dampening possibilities.

4. Miscalibration/Poor readings

Incorrect measurements could happen due to equipment malfunction or miscalibration. A minimum calibration requirement will need to be established in order to reduce any false readings. This faulty data could either miss dangerous vibrations or send an alert when there is no threat present; which could unnecessarily halt construction. To reduce the chance of that happening, rigorous calibrations will be made.

5. Internet Connectivity

If the connectivity should fail, alerts would not be sent and important data would not be saved. The loss of connection could be due to a malfunctioning inner component, or the hotspot itself. If connectivity issues were to present themselves, the built in switch would notify the necessary personnel. This would be accomplished by programming an immediate alert to be sent if transmission is lost.

### 5.1 Probability-Impact Matrix

The probability-impact matrix is often used for risk management and the implementation of a mitigation plan. As seen in Figure 3, a matrix is used to plot potential risks to determine what aspect of the product or process is most vulnerable. After determining the likelihood of a problem arising, the impact of the problem is plotted. The more likely and the higher the impact the higher the risk. These high risks call for a mitigation or contingency plan to offset the possibility of a problem going wrong.


Figure 3: Traditional probability-impact matrix. Green areas represent low risk, yellow medium risk, and red high risk.

To assess the risks listed above, they were each given a number and plotted on a probability-impact matrix (Figure 4). The important thing to note is that there are overall more risks in green. The fact that there is no red-risks shows us that our design may prove to be reliable and useful. There are two risks that need to be monitored more closely, risks 1 and 4. Although unlikely breaking the case would render it useless; with its sensitive measuring equipment and electronics exposed to the elements it would not last long. Risk 4 should never occur, although, it is possible for something to go wrong during the production process or something to be missed during quality control. If the sensor does not perform as it should and sends incorrect data then construction workers may create vibrations that exceed the accepted. With incorrect data being sent it is possible to generate thousands of dollars in damage without realizing it. Our next step in this process is risk mitigation.


Figure 4: The risks probability - impact matrix above shows the 5 ranked risks according to their likelihood and potential impact..

## 6 Technology Readiness Level

Critical Design Elements - before readiness levels can be assigned, critical design elements need to be evaluated. Each of the elements below determine how well the product performs and each is a work in progress.

1. Battery
- Currently the “off-the-shelf” battery pack being used should have enough power to reach the set requirement of 1 month.
- The product will evolve after much testing into a product that consumes less power and in turn lasts longer.
- The battery will store the energy collected from the solar panel.
2. Case
- The outer case of the product is planned to be made with a durable shockproof ABS plastic.
- Though the prototype housing will be 3D-printed, the final design next semester will incorporate ABS as the housing material. More research needs to be done next semester with ABS material.
3. Sensor
- Research into the vibration sensor and geophone used in the vibration monitoring system has been completed. Next semester numerous performance and calibration tests will be performed on the sensors to test durability and accuracy.


Figure 5: Technology readiness levels. A generalized readiness chart depicts the stages during a project’s development. Ranging from 1 through 8 it characterizes the point in product development.

Overall our current project stands at a comfortable technology readiness level (TRL) of
3. Smart Vibes is examining individual components of the product and testing them to ensure they all work in unison. Once all this testing is done, leading up to next semester, we will begin the construction and testing in an outdoor environment. At the end of the Spring semester we will be at a TRL of 5 to 6. We will also have an operating prototype that will act as our first baseline.

## 7 Gantt Chart

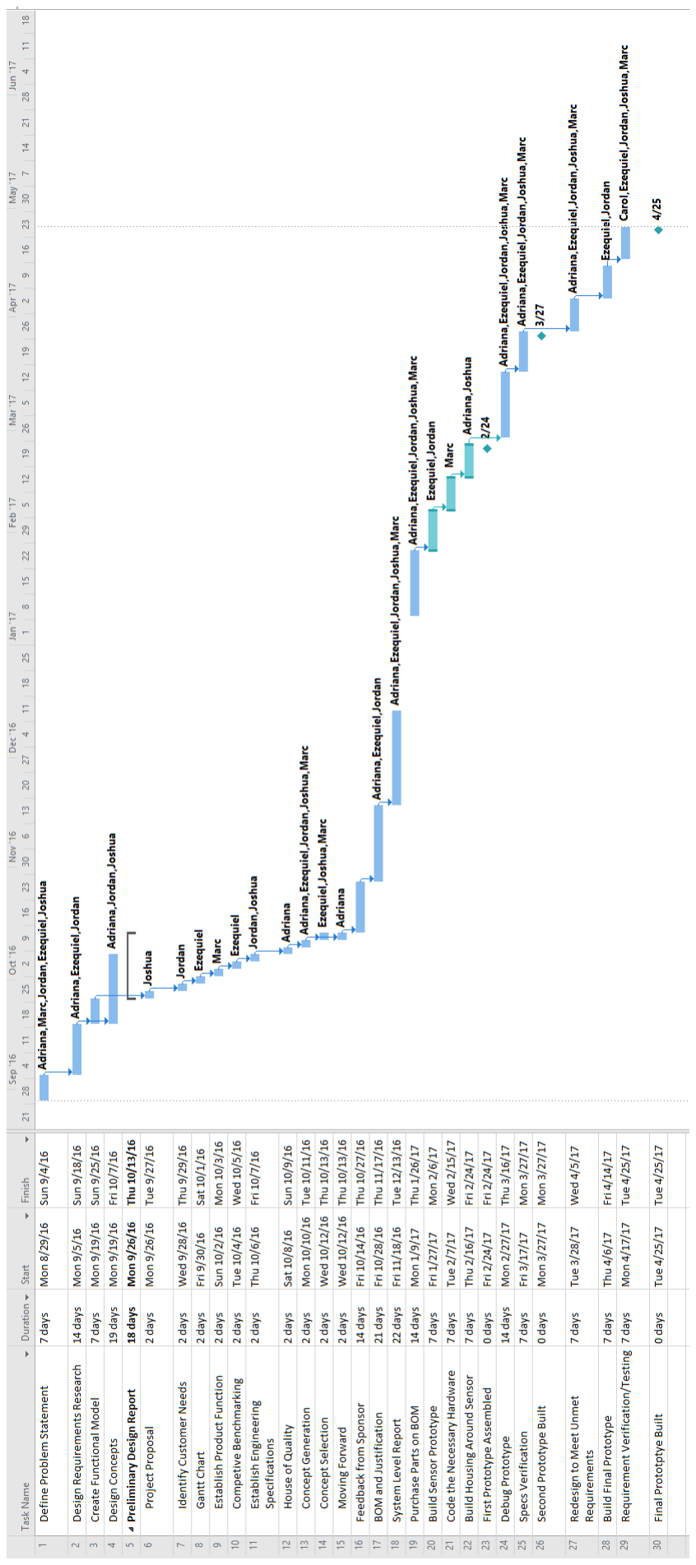
[picture p30: figure]

Figure 6: Project schedule. The second semester shows a couple of milestones that Smart Vibes will achieve.

## References

[1] “Vibration Standards.” Vibration Standards. N.p., n.d. Web. 17 Nov. 2016.
[2] “Mining and Blasting.” Mining and Blasting. N.p., n.d. Web. 17 Nov. 2016.
