MarcEdwin/Design2/reports/final/enclosure_with_sensors.jpg

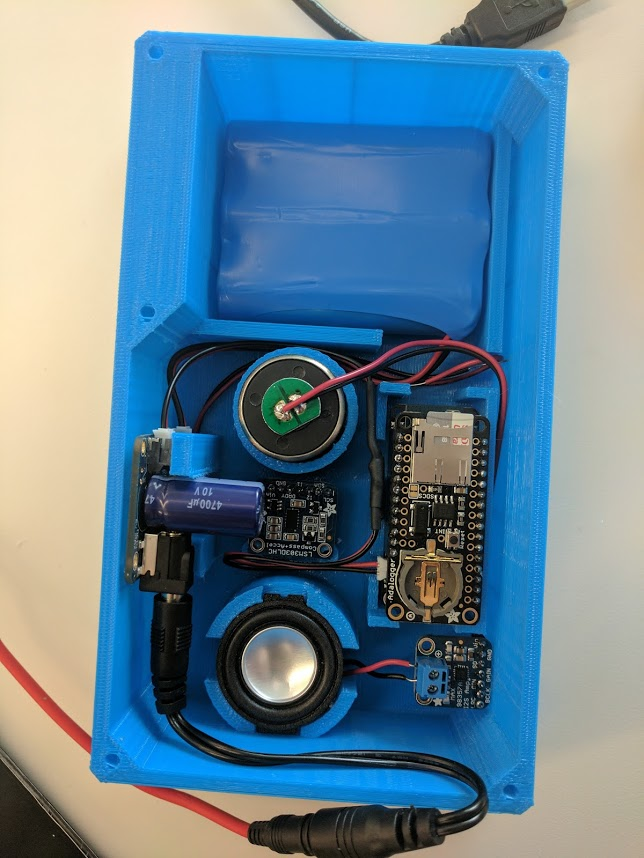
reports/final/enclosure_with_sensors.jpg
