MarcEdwin/Design2/reports/final/solar_panel.jpg

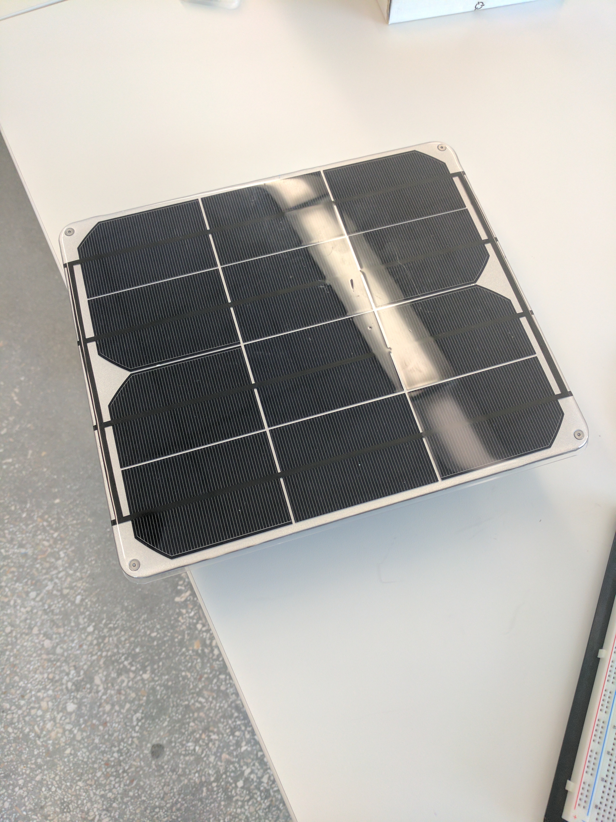
reports/final/solar_panel.jpg
