MarcEdwin/Design2/sldr/src/design.jpg

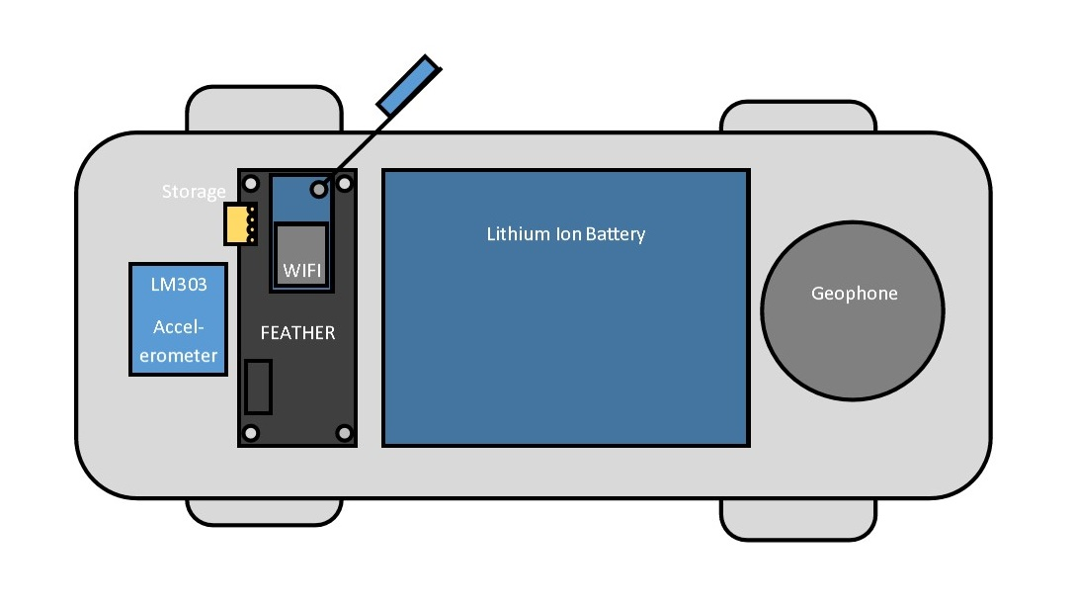
sldr/src/design.jpg
