MarcEdwin/Design2/workshops/timer_workshop/tek00002.png

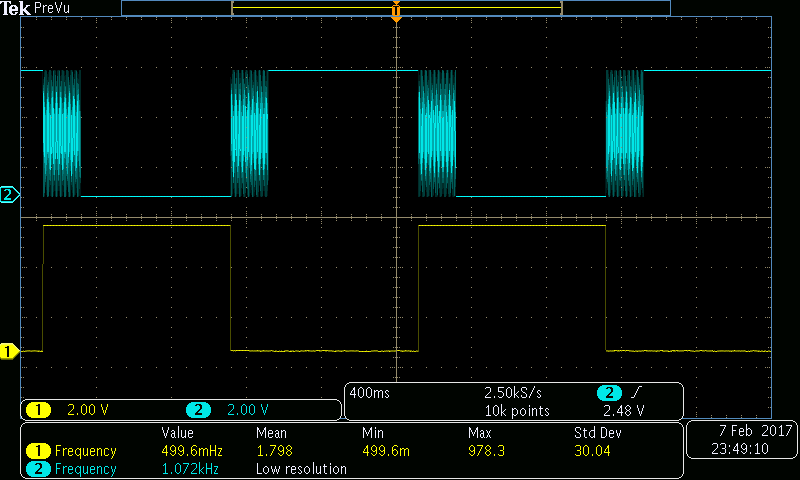
workshops/timer_workshop/tek00002.png
