MarcEdwin/Design2/sldr/src/bom.png

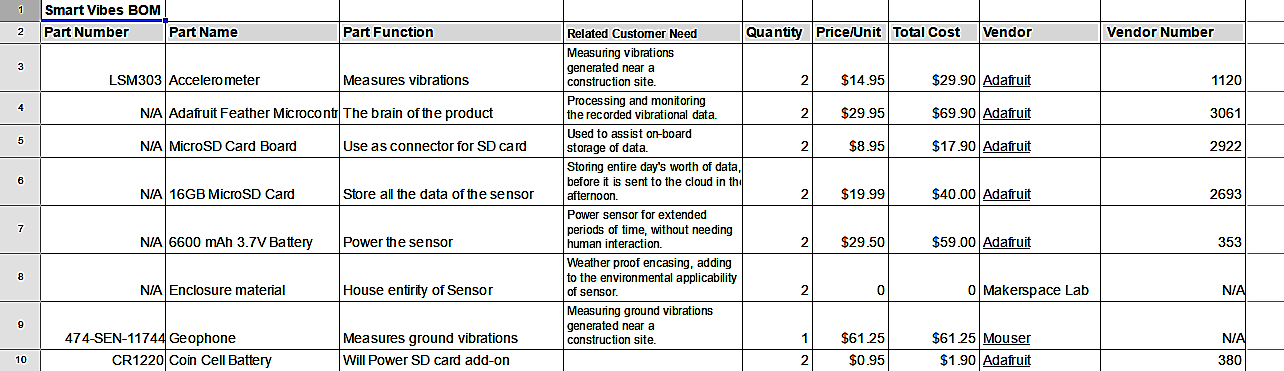
sldr/src/bom.png
