MarcEdwin/Design2/designs/small box.STEP

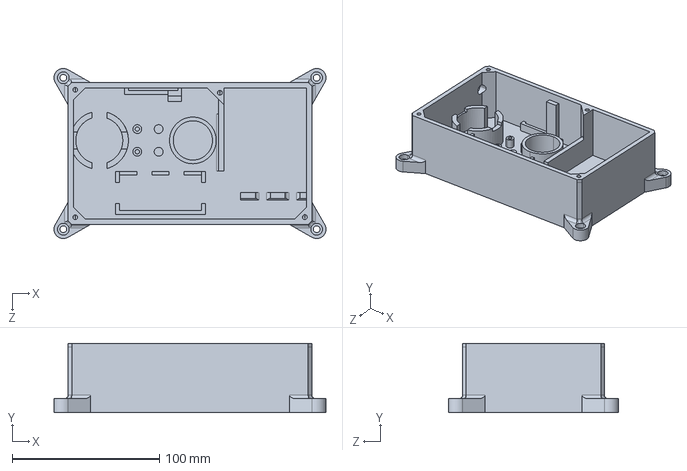
[picture p44: CAD file, 2017-04-12]
designs/small box.STEP
184.9 x 47.1 x 115.7 mm
