MarcEdwin/Design2/(list of files, cad)

Other CAD files:
designs/small box.SLDPRT
designs/small box.STL
