MarcEdwin/Design2/(list of files, drawings)

Other design files:
fritzing_objects/breadboard_layout.fzz
