MarcEdwin/Design2/source_code/arduino_sketches/accelerometer/AP_WebServeracclerometer/AP_WebServeracclerometer.ino

/*
  WiFi Web Server LED Blink

 A simple web server that lets you blink an LED via the web.
 This sketch will create a new access point (with no password).
 It will then launch a new server and print out the IP address
 to the Serial monitor. From there, you can open that address in a web browser
 to turn on and off the LED on pin 13.

 If the IP address of your shield is yourAddress:
 http://yourAddress/H turns the LED on
 http://yourAddress/L turns it off

 This example is written for a network using WPA encryption. For
 WEP or WPA, change the Wifi.begin() call accordingly.

 Circuit:
 * WiFi shield attached
 * LED attached to pin 13

 created 25 Nov 2012
 by Tom Igoe
 */
#include <SPI.h>
#include <Adafruit_WINC1500.h>
#include <Wire.h>
#include <Adafruit_Sensor.h>
#include <Adafruit_LSM303_U.h>

// Define the WINC1500 board connections below.
// If you're following the Adafruit WINC1500 board
// guide you don't need to modify these:
#define WINC_CS   8
#define WINC_IRQ  7
#define WINC_RST  4
#define WINC_EN   2     // or, tie EN to VCC
// The SPI pins of the WINC1500 (SCK, MOSI, MISO) should be
// connected to the hardware SPI port of the Arduino.
// On an Uno or compatible these are SCK = #13, MISO = #12, MOSI = #11.
// On an Arduino Zero use the 6-pin ICSP header, see:
//   https://www.arduino.cc/en/Reference/SPI

// Setup the WINC1500 connection with the pins above and the default hardware SPI.
Adafruit_WINC1500 WiFi(WINC_CS, WINC_IRQ, WINC_RST);

// Or just use hardware SPI (SCK/MOSI/MISO) and defaults, SS -> #10, INT -> #7, RST -> #5, EN -> 3-5V
//Adafruit_WINC1500 WiFi;

// **** WARNING ****
// If running this example on an Uno or compatible you MUST change the LED_PIN
// value below from 13 to something else that doesn't conflict with the SPI
// pins.  Try pin 9 for example.
// **** WARNING ****
#define LED_PIN  13  // This example assumes you have a LED connected to pin 13
                     // (with a resistor to limit current!).  Connect LED anode
                     // (longer leg) to pin 9, then LED cathode (shorter pin)
                     // through a resistor (~300-1k ohm) to ground.

char ssid[] = "feather";      //  created AP name
char pass[] = "wing";         // (not supported yet)

int status = WL_IDLE_STATUS;
Adafruit_WINC1500Server server(80);

Adafruit_LSM303_Accel_Unified accel = Adafruit_LSM303_Accel_Unified(0); // create accelerometer object

double magnitude; // store the magnitude of acceleration
int counter = 0;
int milliseconds;

void setup() {
#ifdef WINC_EN
  pinMode(WINC_EN, OUTPUT);
  digitalWrite(WINC_EN, HIGH);
#endif

  while (!Serial);
  delay(1000);
  Serial.begin(115200);      // initialize serial communication

  Serial.println("Access Point Web Server");

  pinMode(LED_PIN, OUTPUT);      // set the LED pin mode

  // check for the presence of the shield:
  if (WiFi.status() == WL_NO_SHIELD) {
    Serial.println("WiFi shield not present");
    // don't continue
    while (true);
  }

  // print the network name (SSID);
  Serial.print("Creating access point named: ");
  Serial.println(ssid);

  // Create open network. Change this line if you want to create an WEP network:
  if (WiFi.beginAP(ssid) != WL_CONNECTED) {
    Serial.println("Creating access point failed");
    // don't continue
    while (true);
  }
  if (!accel.begin())
  {
    Serial.println("No LSM303 detected ... check your wiring");
    while (1);
  }

  // wait 10 seconds for connection:
  delay(10000);

  // start the web server on port 80
  server.begin();

  // you're connected now, so print out the status
  printWifiStatus();
}


void loop() {
  while (counter<10)
  {
    milliseconds = millis();
    
    // Get a new sensor event
    sensors_event_t event;
    accel.getEvent(&event);
  
    // Get the XYZ readings
    //Serial.print(event.acceleration.x); Serial.print("    "); Serial.print(event.acceleration.y); Serial.print("    "); Serial.println(event.acceleration.z);
  
    // Calculate the magnitude
    magnitude = sqrt(pow(event.acceleration.x, 2) + pow(event.acceleration.y, 2) + pow(event.acceleration.z, 2));
    Serial.print(milliseconds); Serial.print("    "); Serial.println(magnitude);
  
    counter++;
    delay(100);
  Adafruit_WINC1500Client client = server.available();   // listen for incoming clients

  if (client) {                             // if you get a client,
    Serial.println("new client");           // print a message out the serial port
    String currentLine = "";                // make a String to hold incoming data from the client
    while (client.connected()) {            // loop while the client's connected
      if (client.available()) {             // if there's bytes to read from the client,
        char c = client.read();             // read a byte, then
        Serial.write(c);                    // print it out the serial monitor
        if (c == '\n') {                    // if the byte is a newline character
        
          // if the current line is blank, you got two newline characters in a row.
          // that's the end of the client HTTP request, so send a response:
          if (currentLine.length() == 0) {
            // HTTP headers always start with a response code (e.g. HTTP/1.1 200 OK)
            // and a content-type so the client knows what's coming, then a blank line:
            client.println("HTTP/1.1 200 OK");
            client.println("Content-type:text/html");
            client.println();

            // the content of the HTTP response follows the header:
            client.print("Click <a href=\"/H\">here</a> turn the LED on<br>");
            client.print("Click <a href=\"/L\">here</a> turn the LED off<br>");
            client.print("The ACR value:", magnitude);
            // The HTTP response ends with another blank line:
            client.println();
            // break out of the while loop:
            break;
          }
          else {      // if you got a newline, then clear currentLine:
            currentLine = "";
          }
        }
        else if (c != '\r') {    // if you got anything else but a carriage return character,
          currentLine += c;      // add it to the end of the currentLine
        }

        // Check to see if the client request was "GET /H" or "GET /L":
        if (currentLine.endsWith("GET /H")) {
          digitalWrite(LED_PIN, HIGH);               // GET /H turns the LED on
        }
        if (currentLine.endsWith("GET /L")) {
          digitalWrite(LED_PIN, LOW);                // GET /L turns the LED off
        }
      }
    }
    // close the connection:
    client.stop();
    Serial.println("client disconnected");
  }
}

void printWifiStatus() {
  // print the SSID of the network you're attached to:
  Serial.print("SSID: ");
  Serial.println(WiFi.SSID());

  // print your WiFi shield's IP address:
  IPAddress ip = WiFi.localIP();
  Serial.print("IP Address: ");
  Serial.println(ip);

  // print the received signal strength:
  long rssi = WiFi.RSSI();
  Serial.print("signal strength (RSSI):");
  Serial.print(rssi);
  Serial.println(" dBm");
  // print where to go in a browser:
  Serial.print("To see this page in action, open a browser to http://");
  Serial.println(ip);
}
