MarcEdwin/Design2/source_code/arduino_sketches/integrated_sensor/remote_monitoring/remote_monitoring.ino

// Copyright (c) Microsoft. All rights reserved.
// Licensed under the MIT license. See LICENSE file in the project root for full license information.

// Please Use Arduino IDE 1.6.8 or later.

#include "iot_configs.h"

#include <stdlib.h>
#include <stdio.h>
#include <stdint.h>
#include <time.h>
#include <sys/time.h>
#include <SPI.h>
#ifdef ARDUINO_SAMD_FEATHER_M0
#include <Adafruit_WINC1500.h>
#include <Adafruit_WINC1500Client.h>
#include <Adafruit_WINC1500Server.h>
#include <Adafruit_WINC1500SSLClient.h>
#include <Adafruit_WINC1500Udp.h>
#elif defined(ARDUINO_SAMD_ZERO) || defined(ARDUINO_SAMD_MKR1000)
#include <WiFi101.h>
#endif

#include "remote_monitoring.h"
#include "NTPClient.h"

#include <AzureIoTHub.h>
#if defined(IOT_CONFIG_MQTT)
    #include <AzureIoTProtocol_MQTT.h>
#elif defined(IOT_CONFIG_HTTP)
    #include <AzureIoTProtocol_HTTP.h>
#endif

#include "AzureIoTHubClient.h"
// change the next line to use non-Adafruit WINC1500 based boards/shields  
static Adafruit_WINC1500SSLClient sslClient; // for Adafruit WINC1500
//WiFiSSLClient sslClient;              // for WiFi101  
//WiFiClientSecure sslClient;           // for ESP8266 
static AzureIoTHubClient iotHubClient;

#ifdef ARDUINO_SAMD_FEATHER_M0
#define WINC_CS   8
#define WINC_IRQ  7
#define WINC_RST  4
#define WINC_EN   2

// Setup the WINC1500 connection with the pins above and the default hardware SPI.
Adafruit_WINC1500 WiFi(WINC_CS, WINC_IRQ, WINC_RST);
#endif

static char ssid[] = IOT_CONFIG_WIFI_SSID;
static char pass[] = IOT_CONFIG_WIFI_PASSWORD;

int status = WL_IDLE_STATUS;

void setup() {
    // The Feather M0 loses it's COM connection with every reset.
    // This 10 s delay allows you to reselect the COM port and open the serial monitor window.
    delay(10000);
    
    initSerial();

    #ifdef WINC_EN
    pinMode(WINC_EN, OUTPUT);
    digitalWrite(WINC_EN, HIGH);
    #endif
    initWifi();
    
    initTime();
	
	iotHubClient.begin(sslClient);
}

void loop() {
    // Run the Remote Monitoring from the Azure IoT Hub C SDK
    // You must set the device id, device key, IoT Hub name and IotHub suffix in
    // remote_monitoring.c
    remote_monitoring_run();
}

void initSerial() {
    // Start serial and initialize stdout
    Serial.begin(115200);
    //Serial.setDebugOutput(true);
}

void initWifi() {
    // Attempt to connect to Wifi network:
    Serial.print("\r\n\r\nAttempting to connect to SSID: ");
    Serial.println(ssid);

    // Connect to WPA/WPA2 network. Change this line if using open or WEP network:
    status = WiFi.begin(ssid, pass);

    while (WiFi.status() != WL_CONNECTED) {
        delay(500);
        Serial.print(".");
    }

    Serial.println("\r\nConnected to wifi");
}

///////////////////////////////////////////////////////////////////////////////////////////////////
void initTime() {
#ifdef ARDUINO_SAMD_FEATHER_M0
    Adafruit_WINC1500UDP     _udp;
#elif defined(ARDUINO_SAMD_ZERO) || defined(ARDUINO_SAMD_MKR1000)
    WiFiUDP     _udp;
#endif

    time_t epochTime = (time_t)-1;

    NTPClient ntpClient;
    ntpClient.begin();

    while (true) {
        epochTime = ntpClient.getEpochTime("0.pool.ntp.org");

        if (epochTime == (time_t)-1) {
            Serial.println("Fetching NTP epoch time failed! Waiting 5 seconds to retry.");
            delay(5000);
        } else {
            Serial.print("Fetched NTP epoch time is: ");
            Serial.println(epochTime);
            break;
        }
    }
    
    ntpClient.end();

    struct timeval tv;
    tv.tv_sec = epochTime;
    tv.tv_usec = 0;

    settimeofday(&tv, NULL);
}
