MarcEdwin/Design2/source_code/arduino_sketches/interrupts/InterruptAccel/InterruptAccel.ino

/*
   This code was taken from https://gist.github.com/jdneo/43be30d85080b175cb5aed3500d3f989
*/
#include <Wire.h>
#include <Adafruit_Sensor.h>
#include <Adafruit_LSM303_U.h>

// THIS CODE DOESN'T WORK!

#define LED_PIN 13

#define CPU_HZ 48000000
#define TIMER_PRESCALER_DIV 1024

#if defined(ARDUINO_SAMD_ZERO) && defined(SERIAL_PORT_USBVIRTUAL)
// Required for Serial on Zero based boards
#define Serial SERIAL_PORT_USBVIRTUAL
#endif

// Assign a unique ID to this sensor at the same time
Adafruit_LSM303_Accel_Unified accel = Adafruit_LSM303_Accel_Unified(54321);

float magnitude; // stores magnitude of X-Y-Z accelerations

void startTimer(int frequencyHz);
void setTimerFrequency(int frequencyHz);
void TC3_Handler();

bool isLEDOn = false;

void setup() {
  Serial.begin(9600);
  //while (!Serial); // pause until serial console opens
  pinMode(LED_PIN, OUTPUT); // set mode of LED pin
  startTimer(10);
}

void loop() {
  // loop doing nothing
}

void setTimerFrequency(int frequencyHz) {
  int compareValue = (CPU_HZ / (TIMER_PRESCALER_DIV * frequencyHz)) - 1;
  TcCount16* TC = (TcCount16*) TC3;
  // Make sure the count is in a proportional position to where it was
  // to prevent any jitter or disconnect when changing the compare value.
  TC->COUNT.reg = map(TC->COUNT.reg, 0, TC->CC[0].reg, 0, compareValue); // map(value, fromLow, fromHigh, toLow, toHigh)
  TC->CC[0].reg = compareValue;
  //Serial.println(TC->COUNT.reg);
  //Serial.println(TC->CC[0].reg);
  while (TC->STATUS.bit.SYNCBUSY == 1); // wait for sync % more info on page 623 of datasheet %
}

void startTimer(int frequencyHz) {
  REG_GCLK_CLKCTRL = (uint16_t) (GCLK_CLKCTRL_CLKEN | GCLK_CLKCTRL_GEN_GCLK0 | GCLK_CLKCTRL_ID_TCC2_TC3) ;
  while ( GCLK->STATUS.bit.SYNCBUSY == 1 ); // wait for sync

  TcCount16* TC = (TcCount16*) TC3;

  TC->CTRLA.reg &= ~TC_CTRLA_ENABLE;
  while (TC->STATUS.bit.SYNCBUSY == 1); // wait for sync

  // Use the 16-bit timer
  TC->CTRLA.reg |= TC_CTRLA_MODE_COUNT16;
  while (TC->STATUS.bit.SYNCBUSY == 1); // wait for sync

  // Use match mode so that the timer counter resets when the count matches the compare register
  TC->CTRLA.reg |= TC_CTRLA_WAVEGEN_MFRQ;
  while (TC->STATUS.bit.SYNCBUSY == 1); // wait for sync

  // Set prescaler to 1024
  TC->CTRLA.reg |= TC_CTRLA_PRESCALER_DIV1024;
  while (TC->STATUS.bit.SYNCBUSY == 1); // wait for sync

  setTimerFrequency(frequencyHz);

  // Enable the compare interrupt
  TC->INTENSET.reg = 0;
  TC->INTENSET.bit.MC0 = 1;

  NVIC_EnableIRQ(TC3_IRQn);

  TC->CTRLA.reg |= TC_CTRLA_ENABLE;
  while (TC->STATUS.bit.SYNCBUSY == 1); // wait for sync
}

void TC3_Handler() {
  TcCount16* TC = (TcCount16*) TC3;
  // If this interrupt is due to the compare register matching the timer count
  // we toggle the LED.
  if (TC->INTFLAG.bit.MC0 == 1) {
    TC->INTFLAG.bit.MC0 = 1;
    
    // Write callback hereinterrupts
    // Get a new sensor event
    sensors_event_t event;
//    __disable_irq(); //disable all 
//    accel.getEvent(&event);
//    __enable_irq(); //enable all interrupts
    magnitude = sqrt(pow(event.acceleration.x, 2) + pow(event.acceleration.y, 2) + pow(event.acceleration.z, 2));
    Serial.println(magnitude);
    //digitalWrite(LED_PIN, isLEDOn);
    //isLEDOn = !isLEDOn;
  }
}
