MarcEdwin/Design2/source_code/arduino_sketches/geophone/InterruptsAndFFT/InterruptsAndFFT.ino

/*

  Example of use of the FFT libray
        Copyright (C) 2014 Enrique Condes

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
*/

#include "arduinoFFT.h"

arduinoFFT FFT = arduinoFFT(); /* Create FFT object */
/*
These values can be changed in order to evaluate the functions
*/
const uint16_t samples = 128; //This value MUST ALWAYS be a power of 2
double samplingFrequency = 200;
/*
These are the input and output vectors
Input vectors receive computed results from FFT
*/
double vReal[samples];
double vImag[samples];

#define SCL_INDEX 0x00
#define SCL_TIME 0x01
#define SCL_FREQUENCY 0x02

#define Theta 6.2831 //2*Pi

void setup()
{
  while (!Serial);
  Serial.begin(115200);
  Serial.println("Ready");
}

void loop()
{
  for (uint8_t i = 0; i < samples; i++)
  {
    vReal[i] = int16_t(analogRead(A5));
    delay(5);
  }
//  Serial.println("Data:");
//  PrintVector(vReal, samples, SCL_TIME);
  FFT.Windowing(vReal, samples, FFT_WIN_TYP_HAMMING, FFT_FORWARD);  /* Weigh data */
//  Serial.println("Weighed data:");
//  PrintVector(vReal, samples, SCL_TIME);
  FFT.Compute(vReal, vImag, samples, FFT_FORWARD); /* Compute FFT */
//  Serial.println("Computed Real values:");
//  PrintVector(vReal, samples, SCL_INDEX);
//  Serial.println("Computed Imaginary values:");
//  PrintVector(vImag, samples, SCL_INDEX);
  FFT.ComplexToMagnitude(vReal, vImag, samples); /* Compute magnitudes */
//  Serial.println("Computed magnitudes:");
//  PrintVector(vReal, (samples >> 1), SCL_FREQUENCY);
  double x = FFT.MajorPeak(vReal, samples, samplingFrequency);
  Serial.println(x, 6);
  //while(1); /* Run Once */
  // delay(2000); /* Repeat after delay */
}

void PrintVector(double *vData, uint8_t bufferSize, uint8_t scaleType)
{
  for (uint16_t i = 0; i < bufferSize; i++)
  {
    double abscissa;
    /* Print abscissa value */
    switch (scaleType)
    {
      case SCL_INDEX:
        abscissa = (i * 1.0);
  break;
      case SCL_TIME:
        abscissa = ((i * 1.0) / samplingFrequency);
  break;
      case SCL_FREQUENCY:
        abscissa = ((i * 1.0 * samplingFrequency) / samples);
  break;
    }
    Serial.print(abscissa, 6);
    Serial.print(" ");
    Serial.print(vData[i], 4);
    Serial.println();
  }
  Serial.println();
}
