MarcEdwin/Design2/source_code/arduino_sketches/network/CheckWifi101FirmwareVersion/CheckWifi101FirmwareVersion.ino

/*
 * This example check if the firmware loaded on the WiFi101
 * shield is updated.
 *
 * Circuit:
 * - WiFi101 Shield attached
 *
 * Created 29 July 2015 by Cristian Maglie
 * This code is in the public domain.
 */
#include <SPI.h>
#include <WiFi101.h>

void setup() {
  //Configure pins for Adafruit ATWINC1500 Feather
  WiFi.setPins(8,7,4,2);
  
  // Initialize serial
  Serial.begin(9600);
  while (!Serial) {
    ; // wait for serial port to connect. Needed for native USB port only
  }

  // Print a welcome message
  Serial.println("WiFi101 firmware check.");
  Serial.println();

  // Check for the presence of the shield
  Serial.print("WiFi101 shield: ");
  if (WiFi.status() == WL_NO_SHIELD) {
    Serial.println("NOT PRESENT");
    return; // don't continue
  }
  Serial.println("DETECTED");

  // Print firmware version on the shield
  String fv = WiFi.firmwareVersion();
  Serial.print("Firmware version installed: ");
  Serial.println(fv);

  // Print required firmware version
  Serial.print("Firmware version required : ");
  Serial.println(WIFI_FIRMWARE_REQUIRED);

  // Check if the required version is installed
  Serial.println();
  if (fv == WIFI_FIRMWARE_REQUIRED) {
    Serial.println("Check result: PASSED");
  } else {
    Serial.println("Check result: NOT PASSED");
    Serial.println(" - The firmware version on the shield do not match the");
    Serial.println("   version required by the library, you may experience");
    Serial.println("   issues or failures.");
  }
}

void loop() {
  // do nothing
}
