MarcEdwin/Design2/source_code/arduino_sketches/integrated_sensor/remote_monitoring/iot_configs.h

// Copyright (c) Microsoft. All rights reserved.
// Licensed under the MIT license. See LICENSE file in the project root for full license information.

#ifndef IOT_CONFIGS_H
#define IOT_CONFIGS_H

/**
 * WiFi setup
 */
#define IOT_CONFIG_WIFI_SSID            "MER"
#define IOT_CONFIG_WIFI_PASSWORD        "Exodia12"

/**
 * Find under Microsoft Azure IoT Suite -> DEVICES -> <your device> -> Device Details and Authentication Keys
 * String containing Hostname, Device Id & Device Key in the format:
 *  "HostName=<host_name>;DeviceId=<device_id>;SharedAccessKey=<device_key>"
 */

//#define IOT_CONFIG_CONNECTION_STRING "HostName=TestIOT946.azure-devices.net;DeviceId=feather;SharedAccessKey=hJQabSm2Iev+Yk0NjHzuq3lgCljj5oO2206cy1znyuI="
#define IOT_CONFIG_CONNECTION_STRING "HostName=TestIOT946.azure-devices.net;DeviceId=feather;SharedAccessKey=d6rKr5sxaGdrzg8li+/cewPr+K6BiljaCBJ+GaAwwEU="
/**
 * Choose the transport protocol
 */
#define IOT_CONFIG_MQTT                 // uncomment this line for MQTT
//#define IOT_CONFIG_HTTP              // uncomment this line for HTTP

#endif /* IOT_CONFIGS_H */
