MarcEdwin/Design2/(commit log)

2017-02-02 Update BOM
2017-02-02 arduino manual
2017-02-02 Create a blank Arduino sketch for workshop 3 on timers and interrupts
2017-02-02 Move Arduino programming notebook pdf to workshop 3 folder
2017-02-03 Update bill of materials
2017-02-03 Completed the BOM and functional diagram
2017-02-03 COMPLETE: BOM and functional diagram
2017-02-07 Modify Arduino sketch for workshop on timers
2017-02-07 Add oscilloscope captures for workshop on timers
2017-02-07 Update timer workshop Arduino sketch
2017-02-07 Add proper waveform generated by interrupt challenge for the timer workshop
2017-02-07 Finish Arduino sketch for timer workshop
2017-02-07 Modify Arduino sketch for timer workshop
2017-02-17 Upload Arduino sketches for working with the Feather
2017-02-24 Add Arduino sketch used for the I2C workshop
2017-03-02 bom inventory update
2017-03-03 Update and add more Arduino sketches to work with the Feather
2017-03-15 Add the first sketch to that I used to test the accelerometer connected to the microncontroller
2017-03-15 Add the first Fritzing design
    [breadboard_layout.fzz]
2017-03-18 Update accelerometer Arduino sketch
2017-03-21 Rename I2C workshop to timer workshop
2017-03-21 Update source code with interrupts code
2017-03-21 Rename timer workshop to sensor data acquisition
2017-03-21 Update breadboard Fritzing
    [breadboard_layout.fzz]
2017-03-27 Update arduino sketches
2017-04-01 Add a sketch that puts together all the parts of the sensor
2017-04-08 Upload a file to store future improvements to sensor
2017-04-11 Add the sketches for the final sensor in the integrate_sensor folder
2017-04-11 Modify code to where it compiles without errors but it doesn't look like its pushing data to cloud
    [iot_configs.h, lsm303dlhc.cpp, lsm303dlhc.h, remote_monitoring.c]
2017-04-12 Added note to BOM
    added new notes to remember to update table with cost of parts after first order
2017-04-12 Solidworks box Rev 1
    [small box.SLDPRT]
2017-04-16 Add new speaker and accelerometer sketch
2017-05-21 Go back to an earlier date and fix Feather setup instructions for Arduino
