MarcEdwin/Design2/(notices)

Notices in the files:
source_code/arduino_sketches/geophone/InterruptsAndFFT/InterruptsAndFFT.ino:
This program is free software: you can redistribute it and/or modify
it under the terms of the GNU General Public License as published by
the Free Software Foundation, either version 3 of the License, or
(at your option) any later version.
